jamadir/Komplexlabor/README.md

# Komplexlabor
Mechatronik Komplexlabor
Gemeinsamer Projektordner

Der Bericht: https://1drv.ms/w/s!AsvuwZcwYDiNgcJC_qBhzYxd2YB7aw?e=XfTh4c

Latex: https://www.overleaf.com/7794929636vkyntkxffhfc
