jamadir/Komplexlabor/Dokumentation/Präsentation Kugellabyrinth.pptx

## Kugellabyrinth

Wilhelmshaven, 20. Dezember 2022

- Komplexlabor Mechatronik
- Jannes Dirks, Jakob Kramer, Felix Merbt

## Inhalt

1. Analyse der Aufgabenstellung
2. Konzeptionierung
  1. Mechanische Teillösungen
  2. Auswahl des Antriebskonzepts
3. Konstruktionsphase
4. Fertigung
5. Programmierung
6. Inbetriebnahme / Testphase

Titel

## Analyse der Aufgabenstellung

- Kugellabyrinth-Spiel für Zwecke der Öffentlichkeitsarbeit
- Fernbedienung steuert Gerät mittels Lage- und Drehratensensor
- Betriebsspannung 12 V DC
- Material: Acrylglas-Laserzuschnitte
- Fertigung nur durch „Bordmittel“
- Baugröße: 200 x 200 x 100 mm
- Spielfläche des Labyrinths: 100 x 100 mm
- Abgabe: 20.12.2022

## Konzeptionierung

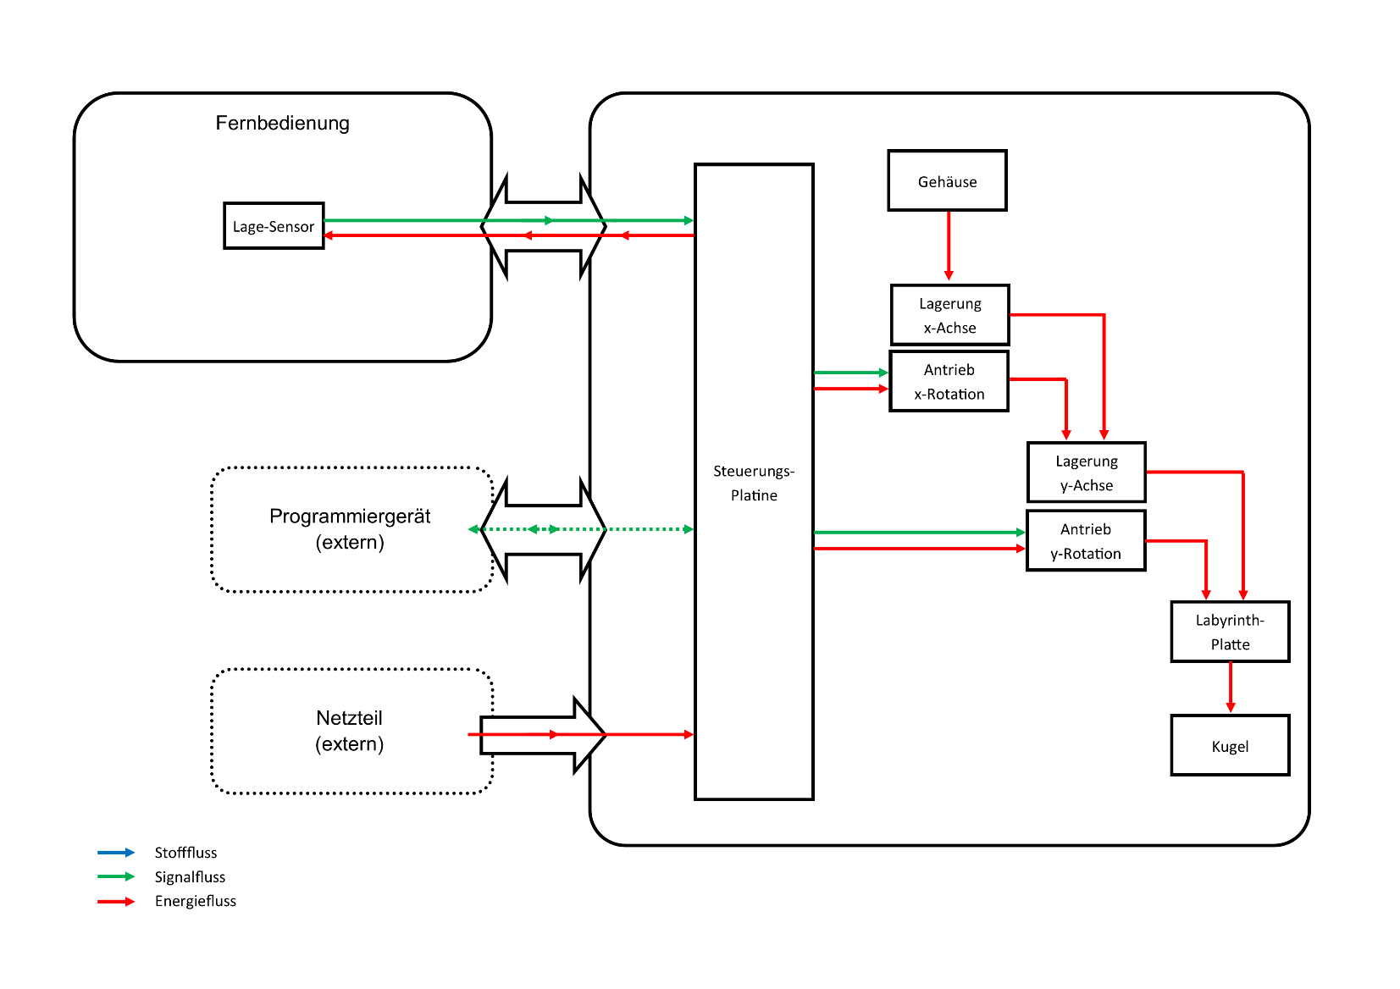
[picture p1: figure]

Bild 1

## Konzeptionierung

- Simples Design der Fernbedienung
- Servomotoren treiben Labyrinth direkt über Hebelarm an
- Steuerung mittels Arduino nano
- Achsen direkt in Material gelagert
- Verbindung zwischen Fernbedienung und Gerät mit USB-C

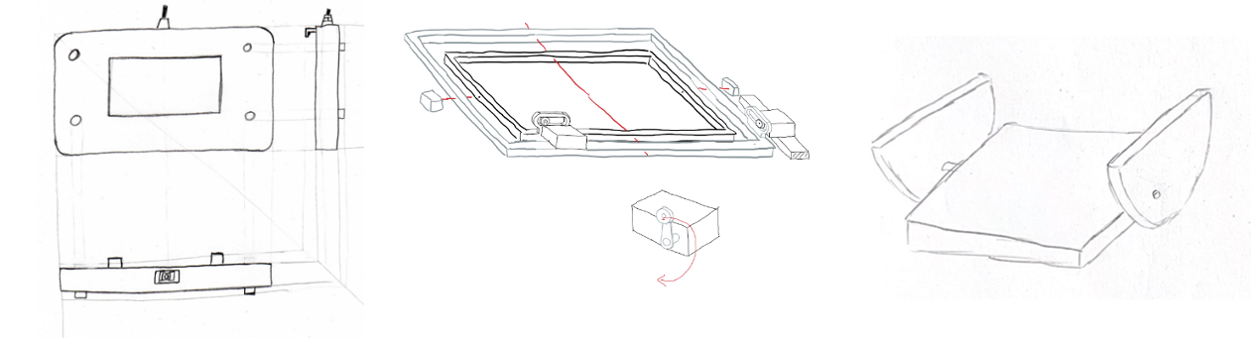
[picture p2: figure]

Bild 2

## Konstruktionsphase

- Festlegung auf die jeweiligen Teillösungen
- Ausarbeitung der Konzepte
- Grobes Skizzieren der Gesamtbaugruppe im Team
- Aufteilen der Baugruppen
- Konstruieren der Baugruppen
- Zusammenführen zur Gesamtbaugruppe
- Anpassen von Fehlkonstruktionen
- Verbesserung und Weiterentwicklung nach den Testaen

## Fertigung

- Fertigung Ausschließlich in der Hochschule
1. Raum H413b
2. Werkstatt ME 05
3. Lasercutter Me 09
- Besonderheit: Anpassung der Klemmung für die Baugruppe „Labyrinth“

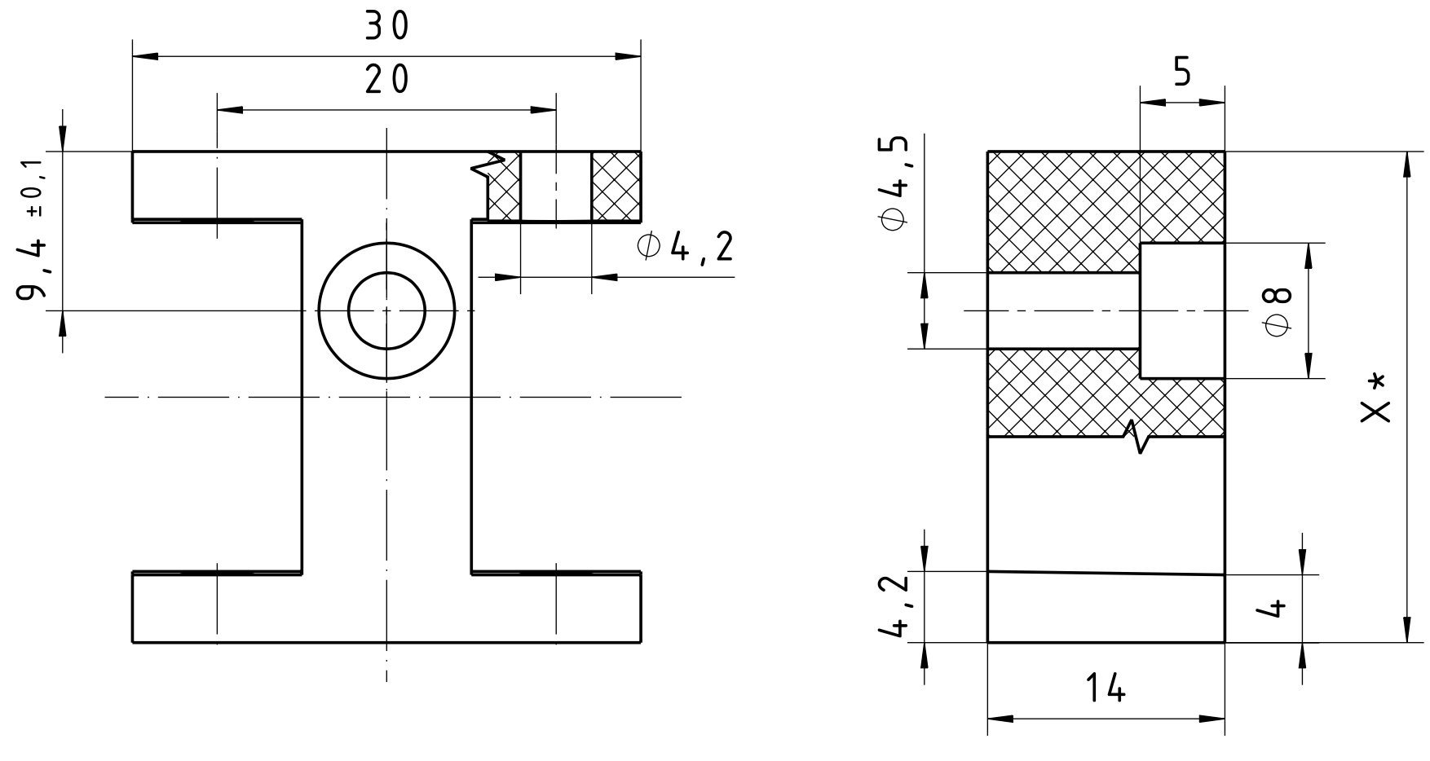
[picture p3: figure]

Bild 3

## Programmierung und Hardware

- Versuchsaufbau mit dem Motor HS-311 am Arduino Uno
- Versuchsaufbau mit dem Sensor MPU 6050 am Arduino Uno
- Erstes Verknüpfen von Motor und Sensor
- Weiterentwicklung des Programms
- Entwickeln und Verbessern der Hardware durch Arduino Nano

## Inbetriebnahme / Testphase

- Elektronikfehler, USB-C Codierung
- Elektronikfehler, EMV Probleme bei Versorgungsspannung > 5V
- Hebelarm kürzen, da nicht Plan
- Debugging im Programm
- Geräuschentwicklung in der Lagerung

## Erprobung des Anwendungsfalles

Testspiele von Probanden mit anschließender Kurzbewertung

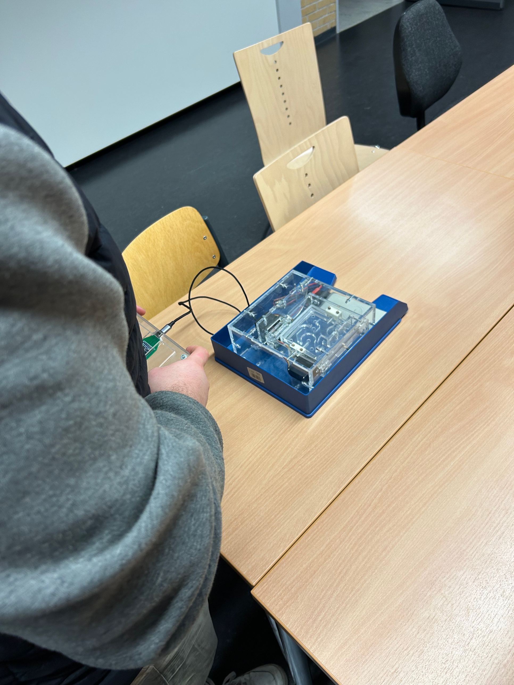
[picture p4: figure]
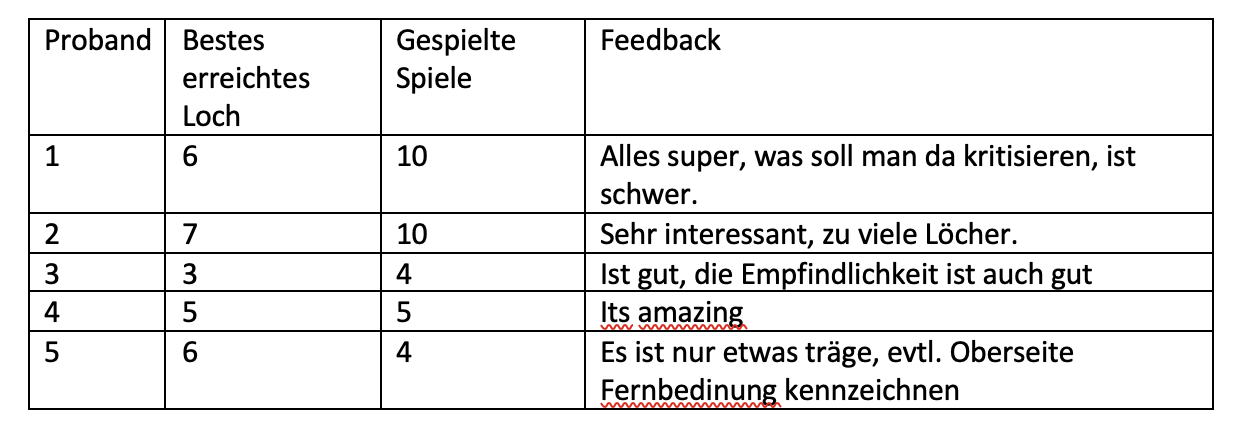
[picture p5: figure]

Tabelle 1

Bild 4

## Vielen Dank für Ihre Aufmerksamkeit
