jamadir/Komplexlabor/Dokumentation/Handskizzen/Aufhängung/Aufhängung.pdf

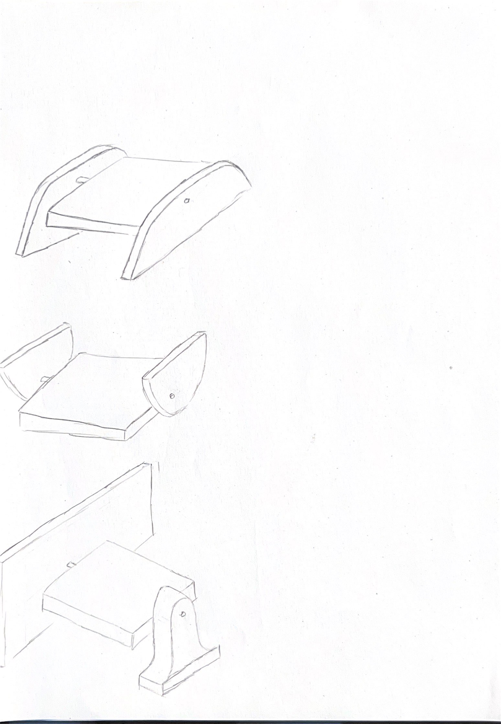
[picture p34: page 1]
