jamadir/Komplexlabor/Dokumentation/Handskizzen/Lagerung/Lagerung.pdf

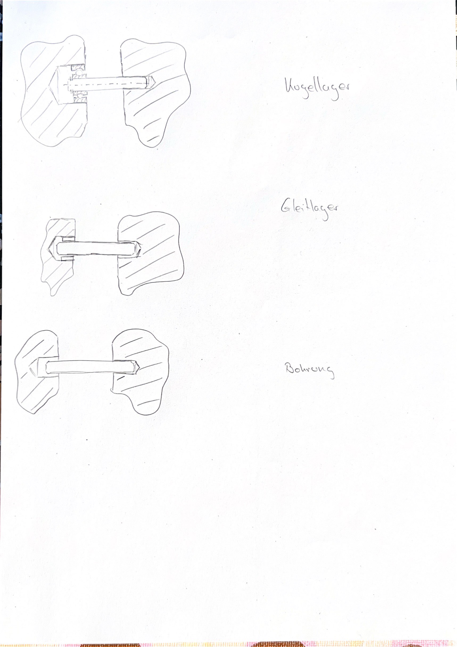
[picture p35: page 1]
