jamadir/Komplexlabor/Dokumentation/Handskizzen/Fernbedienung/Varianten Fernsteuerung Skizzen Schaltplan.pdf

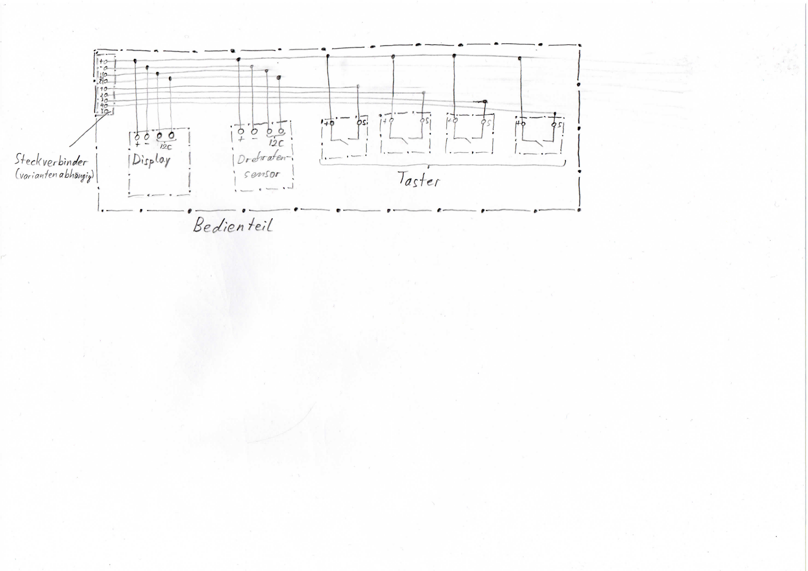
[picture p36: page 1]
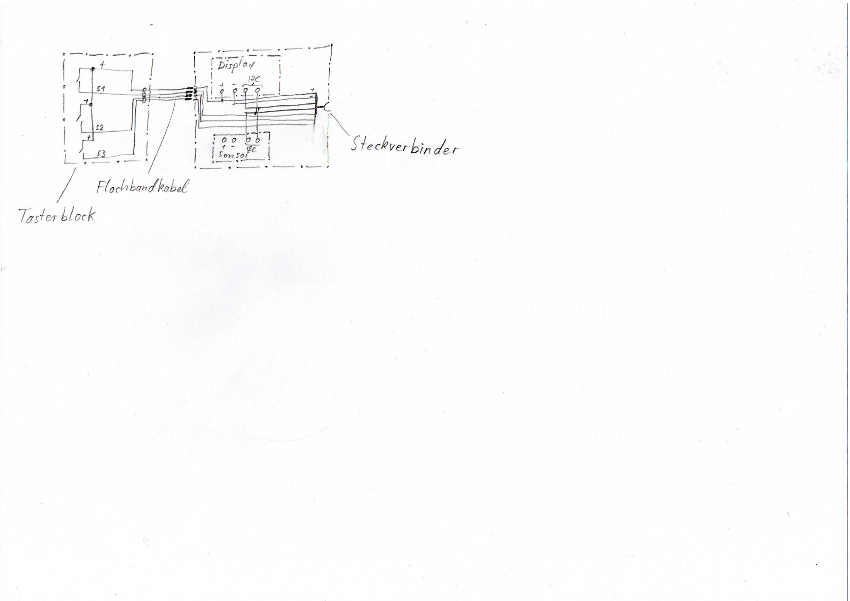
[picture p37: page 2]
