jamadir/Komplexlabor/Dokumentation/Handskizzen/Fernbedienung/Varianten Fernsteuerung.pdf

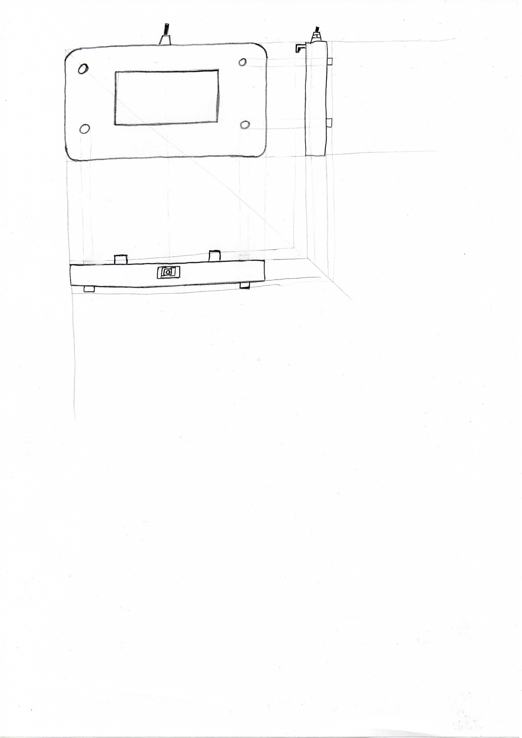
[picture p38: page 1]
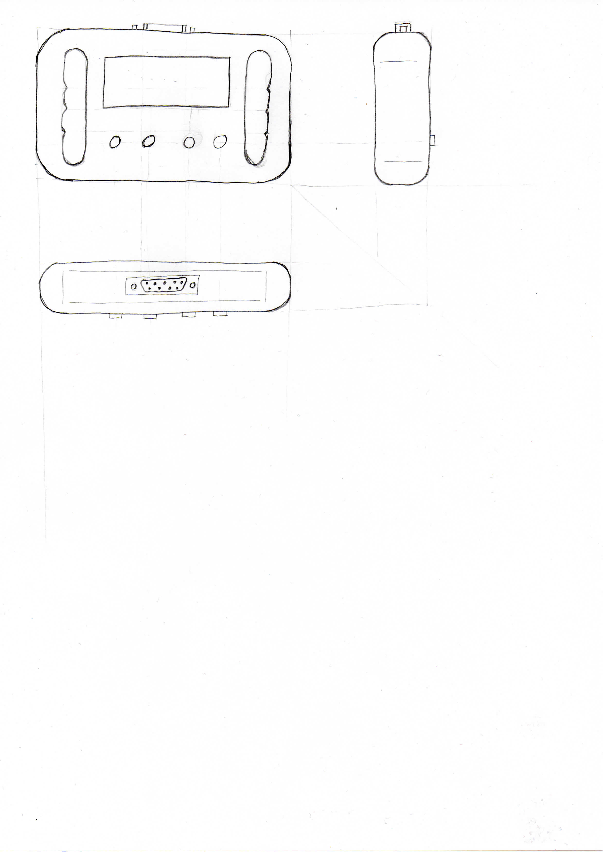
[picture p39: page 2]
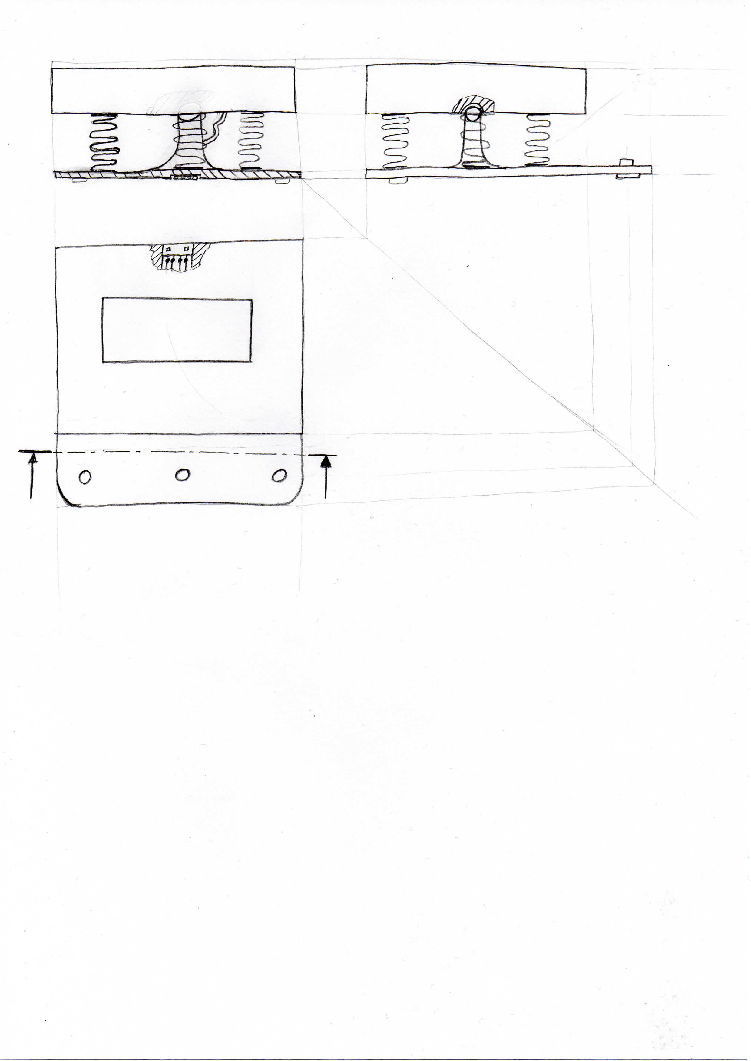
[picture p40: page 3]
