jamadir/Komplexlabor/Dokumentation/Funktionsstruktur/Funktionsstruktur V2.png

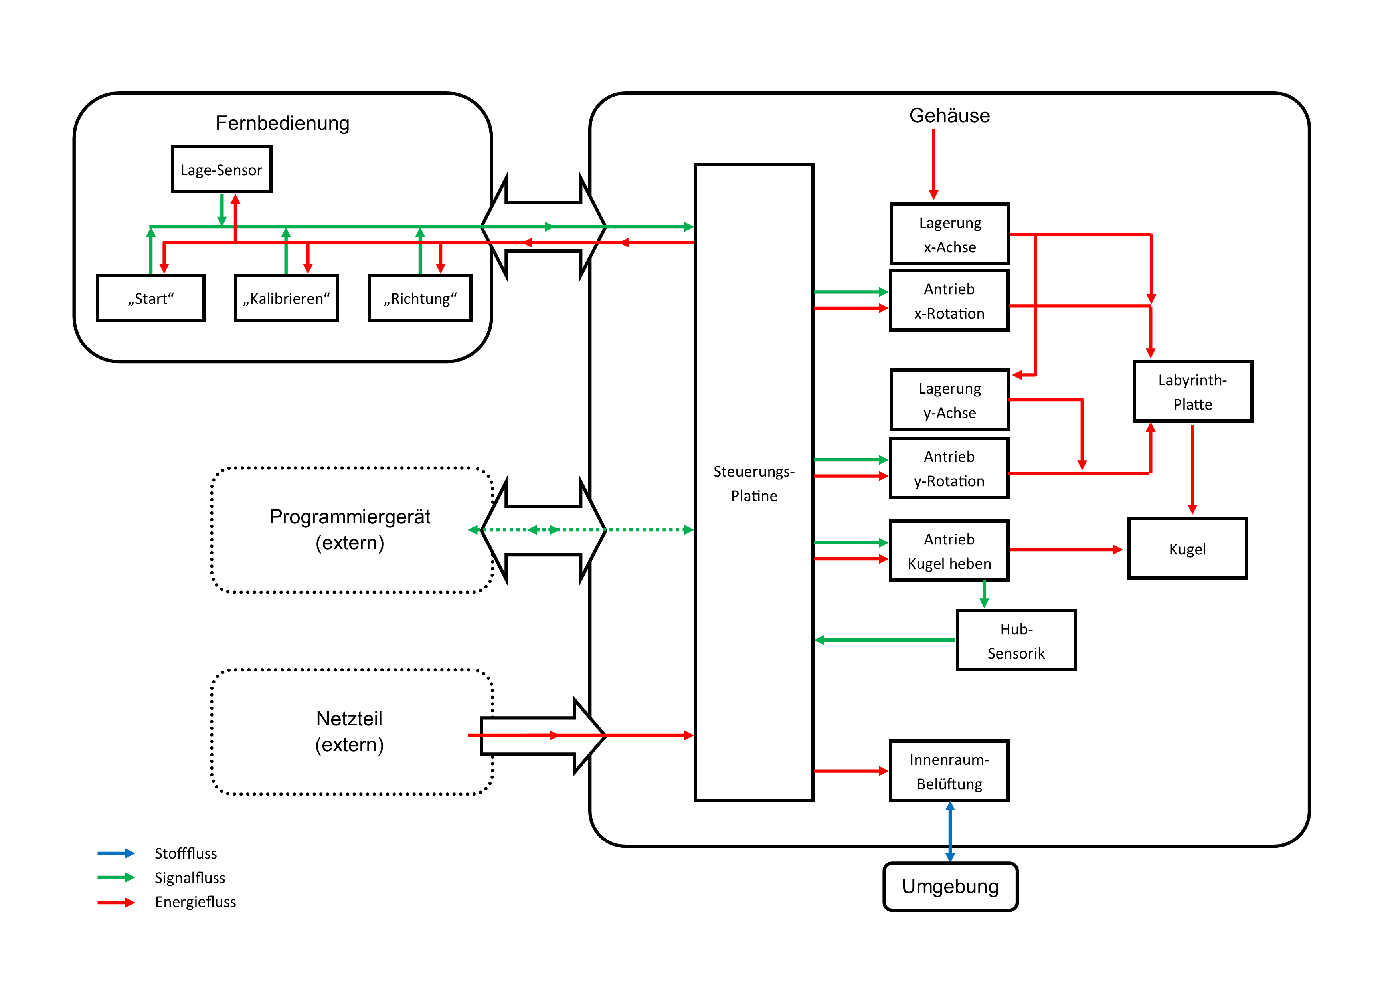
Dokumentation/Funktionsstruktur/Funktionsstruktur V2.png
