jamadir/Komplexlabor/CATIA/603.000.02.000_Aufhaengung/Stückliste Fernsteuerung.xls

1 |  | 2 | 3 | 4 |  |  |  |  | 5 |  | 6
Pos. |  | Menge | Einheit | Benennung |  |  |  |  | Sachnummer/Norm - Kurzbezeichnung |  | Bemerkung
1 |  | 1 | St. | Aufhängung 1 |  |  |  |  | 603.000.02.001
2 |  | 1 | St. | Aufhängung 2 |  |  |  |  | 603.000.02.002
3 |  | 1 | St. | Rahmen 1 |  |  |  |  | 603.000.02.003
4 |  | 1 | St. | Rahmen 1_2 |  |  |  |  | 603.000.02.004
5 |  | 1 | St. | Rahmen 2_1 |  |  |  |  | 603.000.02.005
6 |  | 1 | St. | Rahmen 2_2 |  |  |  |  | 603.000.02.006
7 |  | 2 | St. | Laufschiene |  |  |  |  | 603.000.02.007
8 |  | 1 | St. | Distanzstück |  |  |  |  | 603.000.02.008
9 |  | 1 | St. | Distanzstück L |  |  |  |  | 603.000.02.009
10 |  | 8 | St. | Sicherungsring |  |  |  |  | ANSI_B27_7M_3CM1_4
11 |  | 1 | St. | Servo Horn |  |  |  |  | Alu Servohorn 25T
12 |  | 1 | St. | Stift 15,8
13 |  | 1 | St. | Stift 19
14 |  | 2 | St. | Stift 30
15 |  | 5 | St. | Unterlegscheibe4 |  |  |  |  | ISO 7089 WASHER 4x9
16 |  | 1 | St. | Schraube 8mm |  |  |  |  | ISO_7047_M2.5x8
17 |  | 1 | St. | Schraube 12mm |  |  |  |  | ISO_4762_M2.5x12
18 |  | 2 | St. | Servo Motor |  |  |  |  | Hitec HS-311
19 |  | 2 | St. | Kugellager |  |  |  |  | Bearing w 6 x m2,5
20 |  | 4 | St. | Schraube 20mm |  |  |  |  | ISO 4762 M3x20
21 |  | 4 | St. | Vierkantmutter |  |  |  |  | din 562 m3 04
22 |  | 8 | St. | Senkkopfschraube |  |  |  |  | ISO 10642 M3x10
23 |  | 8 | St. | Mutter M3 |  |  |  |  | ISO 4032 M3
24 |  | 8 | St. | Unterlegscheibe3 |  |  |  |  | ISO 7089 WASHER 3x7
25 |  | 4 | St. | Schraube 16mm |  |  |  |  | ISO 10642 M3x16
26
27
 |  |  |  |  |  |  | Datum | Name |  | Aufhängung
 |  |  |  |  |  | Bearb. | 2022-11-08 | Dirks
 |  |  |  |  |  | Gepr.
 |  |  |  |  |  | Norm.
 |  |  |  |  |  |  |  |  |  |  |  | Blatt
 |  |  |  |  |  |  |  |  |  | 603.000.02.000 |  | 1
 |  |  |  |  |  |  |  |  |  |  |  | 1 Bl.
Zust. | Änderung |  |  | Datum | Name
