jamadir/Komplexlabor/Fertigung/603.000.05.000_Steuer-Platine/SMD BOM 603.000.05.000, 603.000.04.005.xlsx

No. | Quantity | Comment | Designator | Footprint | Value | Manufacturer Part | Manufacturer | Supplier Part | Supplier
1 | 1 | Power connector | CN1 | CONN-TH_2P-P5.08_DB2EV-5.08-2P |  | DB2EV-5.08-2P-GN | DIBO(地博电气) | C395733 | LCSC
2 | 1 | Servo connector | H1 | HDR-TH_6P-P2.54-V-M-1
3 | 1 | ARDUINO_NANO | U1 | COMM-TH_ARDUINO_NANO |  | ARDUINO_NANO |  | C9900017879 | LCSC
4 | 1 | GY521 MODULE | U2 | MPU6050 GY521 TRINITY
5 | 1 | DC-DC step down converter | U3 | DC-DC step down converter
6 | 2 | TYPE-C-31-M-12 | USBC1,USBC2 | USB-C_SMD-TYPE-C-31-M-12 |  | TYPE-C-31-M-12 | 韩国韩荣 | C165948 | LCSC
