jamadir/Komplexlabor/CATIA/Stückliste Kugellabyrinth.xls

1 |  | 2 | 3 | 4 |  |  |  |  | 5 |  | 6
Pos. |  | Menge | Einheit | Benennung |  |  |  |  | Sachnummer/Norm - Kurzbezeichnung |  | Bemerkung
1 |  | 1 | St. | Gehäuse |  |  |  |  | 603.000.01.000
2 |  | 1 | St. | Aufhängung |  |  |  |  | 603.000.02.000
3 |  | 1 | St. | Labyrinth |  |  |  |  | 603.000.03.000
4 |  | 1 | St. | Fernbedienung |  |  |  |  | 603.000.04.000
5 |  | 1 | St. | Steuer-Platine |  |  |  |  | 603.000.05.000
6 |  | 4 | St. | Schraube M3x16 |  |  |  |  | ISO 4762 M3x16
7 |  | 8 | St. | Unterlegscheibe D3,5 |  |  |  |  | ISO 7089
8 |  | 4 | St. | Mutter M3 |  |  |  |  | ISO 4032
9 |  | 1 | St. | Verbindungskabel |  |  |  |  | USB-C
10
11
12
13
14
15
16
17
18
19
20
21
22
23
24
25
26
27
 |  |  |  |  |  |  | Datum | Name |  | Kugellabyrinth
 |  |  |  |  |  | Bearb. | 2022-12-20 | Kramer
 |  |  |  |  |  | Gepr.
 |  |  |  |  |  | Norm.
 |  |  |  |  |  |  |  |  |  |  |  | Blatt
 |  |  |  |  |  |  |  |  |  | 603.000.00.000 |  | 1
 |  |  |  |  |  |  |  |  |  |  |  | 1 Bl.
Zust. | Änderung |  |  | Datum | Name
