jamadir/Komplexlabor/CATIA/603.000.03.000_Labyrinth/Stückliste Labyrinth.xls

1 |  | 2 | 3 | 4 |  |  |  |  | 5 |  | 6
Pos. |  | Menge | Einheit | Benennung |  |  |  |  | Sachnummer/Norm - Kurzbezeichnung |  | Bemerkung
1 |  | 1 | St. | Auffangplatte |  |  |  |  | 603.000.03.001
2 |  | 1 | St. | Zwischenplatte |  |  |  |  | 603.000.03.002
3 |  | 1 | St. | Lauffläche |  |  |  |  | 603.000.03.003
4 |  | 1 | St. | Labyrinthplatte |  |  |  |  | 603.000.03.004
5 |  | 1 | St. | Abdeckplatte |  |  |  |  | 603.000.03.005
6 |  | 1 | St. | Rampe 1 |  |  |  |  | 603.000.03.006
7 |  | 1 | St. | Rampe 2 |  |  |  |  | 603.000.03.007
8 |  | 2 | St. | Lagerblock |  |  |  |  | 603.000.03.008
9 |  | 4 | St. | Sicherungsstift |  |  |  |  | 603.000.03.009
10 |  | 8 | St. | Sicherungsring |  |  |  |  | ANSI_B27_7M_3CM1_4
11 |  | 1 | St. | Kugel 6mm |  |  |  |  | DIN 5401
12
13
14
15
16
17
18
19
20
21
22
23
24
25
26
27
 |  |  |  |  |  |  | Datum | Name |  | Kugellabyrinth
 |  |  |  |  |  | Bearb. | 2022-12-20
 |  |  |  |  |  | Gepr.
 |  |  |  |  |  | Norm.
 |  |  |  |  |  |  |  |  |  |  |  | Blatt
 |  |  |  |  |  |  |  |  |  | 603.000.00.000 |  | 1
 |  |  |  |  |  |  |  |  |  |  |  | 1 Bl.
Zust. | Änderung |  |  | Datum | Name
