jamadir/Komplexlabor/CATIA/603.000.01.000_Gehaeuse/Stückliste Gehäuse.xls

1 |  | 2 | 3 | 4 |  |  |  |  | 5 |  | 6
Pos. |  | Menge | Einheit | Benennung |  |  |  |  | Sachnummer/Norm - Kurzbezeichnung |  | Bemerkung
1 |  | 1 | St. | Boden |  |  |  |  | 603.000.01.001
2 |  | 1 | St. | Seitenwand vorne |  |  |  |  | 603.000.01.002
3 |  | 1 | St. | Seitenwand links |  |  |  |  | 603.000.01.003
4 |  | 1 | St. | Seitenwand hinten |  |  |  |  | 603.000.01.004
5 |  | 1 | St. | Seitenwand rechts |  |  |  |  | 603.000.01.005
6 |  | 1 | St. | Deckel |  |  |  |  | 603.000.01.006
7 |  | 20 | St. | Schraube |  |  |  |  | ISO 4762 - M3x20 - 8.8
8 |  | 20 | St. | Scheibe |  |  |  |  | ISO 7092-3-200 HV
9 |  | 20 | St. | Vierkantmutter |  |  |  |  | DIN 562 - M3 - 04
10
11
12
13
14
15
16
17
18
19
20
21
22
23
24
25
26
27
 |  |  |  |  |  |  | Datum | Name |  | Gehäuse
 |  |  |  |  |  | Bearb. | 2022-12-20 | Kramer
 |  |  |  |  |  | Gepr.
 |  |  |  |  |  | Norm.
 |  |  |  |  |  |  |  |  |  |  |  | Blatt
 |  |  |  |  |  |  |  |  |  | 603.000.01.000 |  | 1
 |  |  |  |  |  |  |  |  |  |  |  | 1 Bl.
Zust. | Änderung |  |  | Datum | Name
