jamadir/Komplexlabor/CATIA/603.000.04.000_Fernsteuerung/Stückliste Fernsteuerung.xls

1 |  | 2 | 3 | 4 |  |  |  |  | 5 |  | 6
Pos. |  | Menge | Einheit | Benennung |  |  |  |  | Sachnummer/Norm - Kurzbezeichnung |  | Bemerkung
1 |  | 1 | St. | Grundplatte |  |  |  |  | 603.000.04.001
2 |  | 2 | St. | Befestigungsplatte |  |  |  |  | 603.000.04.002
3 |  | 1 | St. | Distanzplatte |  |  |  |  | 603.000.04.003
4 |  | 1 | St. | Abdeckplatte |  |  |  |  | 603.000.04.004
5 |  | 1 | St. | Sensorplatine |  |  |  |  | 603.000.04.005
6 |  | 2 | St. | Zylinderstift |  |  |  |  | ISO 2338 - 3 h8 x 12
7 |  | 4 | St. | Schraube |  |  |  |  | ISO 4762 - M3x25 - 8.8
8 |  | 8 | St. | Scheibe |  |  |  |  | ISO 7092-3-200 HV
9 |  | 4 | St. | Sechskantmutter |  |  |  |  | ISO 4032 - M3 - 8
10
11
12
13
14
15
16
17
18
19
20
21
22
23
24
25
26
27
 |  |  |  |  |  |  | Datum | Name |  | Fernsteuerung
 |  |  |  |  |  | Bearb. | 2022-10-31 | Merbt
 |  |  |  |  |  | Gepr.
 |  |  |  |  |  | Norm.
 |  |  |  |  |  |  |  |  |  |  |  | Blatt
 |  |  |  |  |  |  |  |  |  | 603.000.04.000 |  | 1
 |  |  |  |  |  |  |  |  |  |  |  | 1 Bl.
Zust. | Änderung |  |  | Datum | Name
