jamadir/Komplexlabor/CATIA/603.000.04.000_Fernsteuerung/USB-C Breakout Board.stl

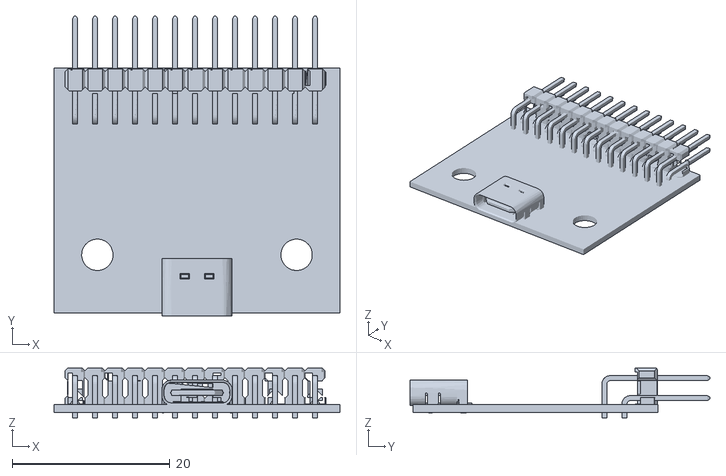
[picture p42: CAD file, 2022-10-18]
CATIA/603.000.04.000_Fernsteuerung/USB-C Breakout Board.stl
36.3 x 38.1 x 6.33
