jamadir/Komplexlabor/Fertigung/603.000.02.000_Aufhaengung/Distanzstueck_Lagerung.stl

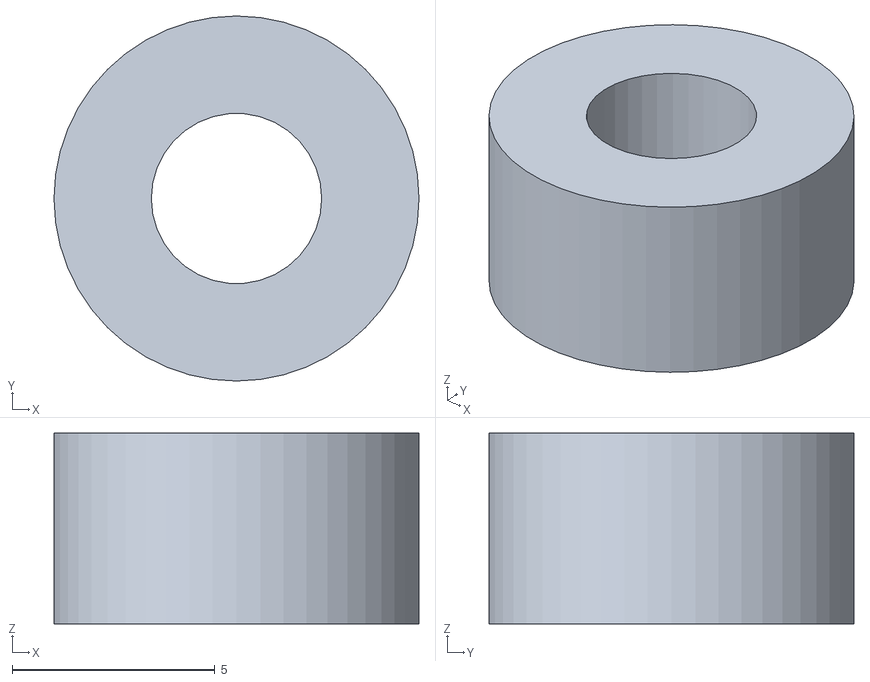
[picture p43: CAD file, 2022-11-28]
Fertigung/603.000.02.000_Aufhaengung/Distanzstueck_Lagerung.stl
9.00 x 9.00 x 4.70
