jamadir/Komplexlabor/Fertigung/603.000.03.000_Labyrinth/Lagereinsatz.stl

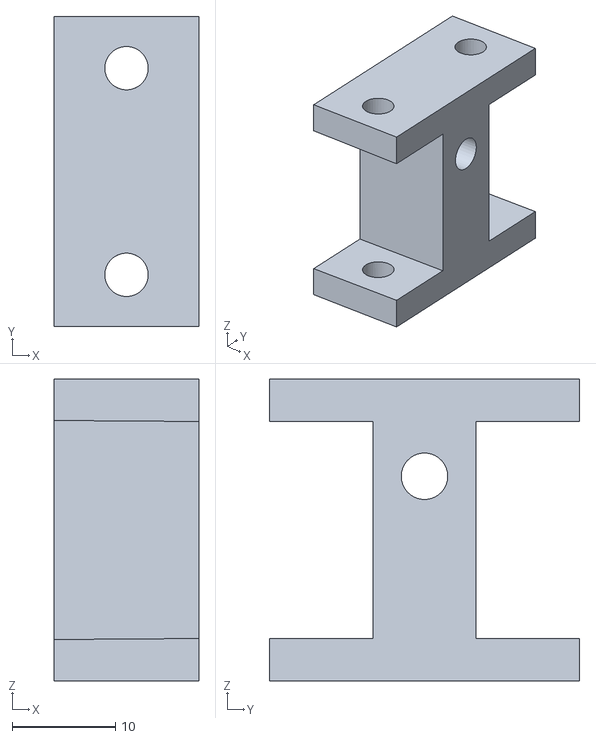
[picture p44: CAD file, 2022-11-28]
Fertigung/603.000.03.000_Labyrinth/Lagereinsatz.stl
14.0 x 30.0 x 29.2
