jamadir/Komplexlabor/Modell prototyp/rahmen aussen innen.stl

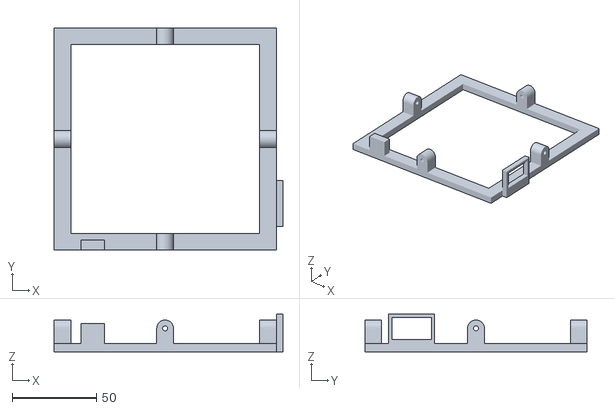
[picture p45: CAD file, 2022-10-09]
Modell prototyp/rahmen aussen innen.stl
136.0 x 132.0 x 22.5
