jamadir/Komplexlabor/Modell prototyp/rahmen aussen ausseb.stl

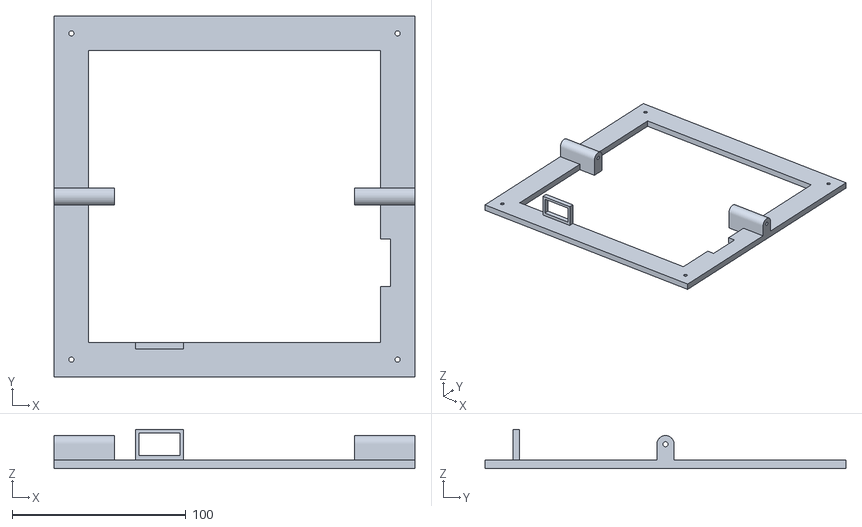
[picture p46: CAD file, 2022-10-09]
Modell prototyp/rahmen aussen ausseb.stl
208.0 x 208.0 x 22.5
