jamadir/Komplexlabor/Modell prototyp/gestell.stl

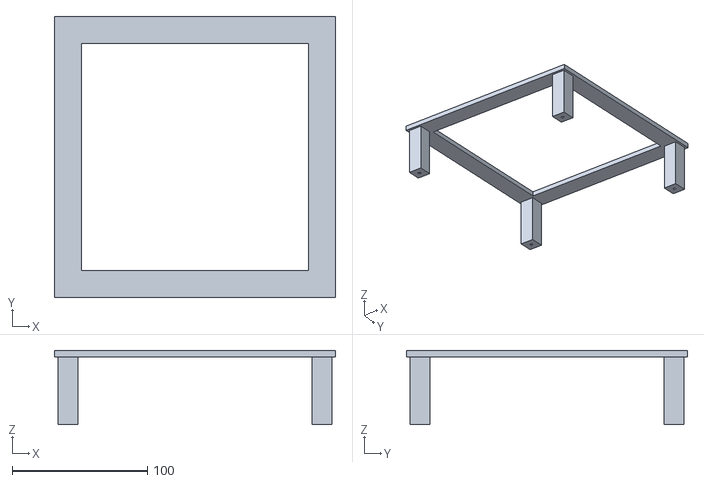
[picture p47: CAD file, 2022-10-09]
Modell prototyp/gestell.stl
208.0 x 208.0 x 55.0
