jamadir/Komplexlabor/Modell prototyp/labyrinth.stl

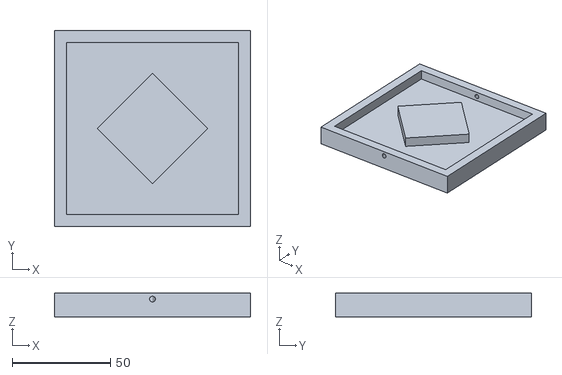
[picture p48: CAD file, 2022-10-08]
Modell prototyp/labyrinth.stl
100.0 x 100.0 x 12.0
