jamadir/Komplexlabor/Modell prototyp/laufschiene.stl

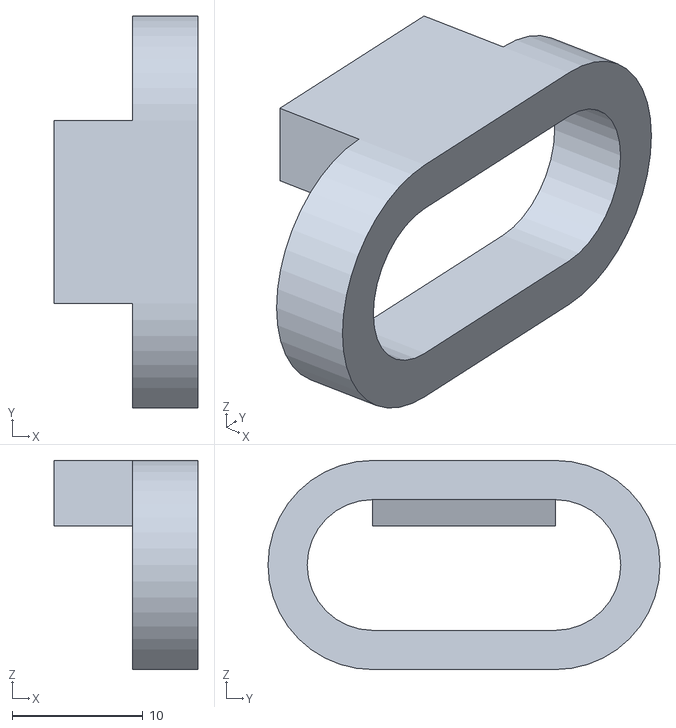
[picture p49: CAD file, 2022-10-08]
Modell prototyp/laufschiene.stl
11.0 x 30.0 x 16.0
