jamadir/Komplexlabor/(list of files, cad)

Other CAD files:
Baugruppe Aufhängung/Armkonstruktion.CATProduct
Baugruppe Aufhängung/Aufhaengung aussen.CATPart
Baugruppe Aufhängung/Aufhaengung und Servos.CATProduct
Baugruppe Aufhängung/Fuehrung.2.CATPart
Baugruppe Aufhängung/Hebelarm.CATPart
Baugruppe Aufhängung/Kugellager.CATPart
Baugruppe Aufhängung/M2.5 Schraube.CATPart
Baugruppe Aufhängung/Rahmen innen.CATPart
Baugruppe Aufhängung/Servo.CATPart
Baugruppe Aufhängung/Servo2.CATPart
Baugruppe Aufhängung/Unterlegscheibe.CATPart
Baugruppe Gehäuse/Deckel.1.CATPart
Baugruppe Gehäuse/Gehause.CATProduct
CATIA/603.000.00.000_Kugellabyrinth.CATProduct
CATIA/603.000.01.000_Gehaeuse/Gehaeuse.CATProduct
CATIA/603.000.01.000_Gehaeuse/Product1.CATProduct
CATIA/603.000.02.000_Aufhaengung/Laufschiene_Lager.CATPart
CATIA/603.000.02.000_Aufhaengung/Rahmen.CATProduct
CATIA/603.000.03.000_Labyrinth/Auffangplatte.CATPart
CATIA/603.000.03.000_Labyrinth/Labyrinth.CATProduct
CATIA/603.000.03.000_Labyrinth/Lagereinsatz.CATPart
CATIA/603.000.03.000_Labyrinth/Rampe 0-6.CATPart
CATIA/603.000.03.000_Labyrinth/Rampe 6-9.CATPart
CATIA/603.000.05.000_Steuer-Platine/Platine/Platine/Platine.CATProduct
Fertigung/603.000.01.000_Gehaeuse/Gehaeuse_Bodenplatte.CATPart
Fertigung/603.000.01.000_Gehaeuse/Gehaeuse_Deckel.CATPart
Fertigung/603.000.01.000_Gehaeuse/Gehaeuse_Seitenplatte_1.CATPart
Fertigung/603.000.01.000_Gehaeuse/Gehaeuse_Seitenplatte_2.CATPart
Fertigung/603.000.01.000_Gehaeuse/Gehaeuse_Seitenplatte_3.CATPart
Fertigung/603.000.01.000_Gehaeuse/Gehaeuse_Seitenplatte_4.CATPart
Fertigung/603.000.02.000_Aufhaengung/Aufhaengung_1.CATPart
Fertigung/603.000.02.000_Aufhaengung/Aufhaengung_2.CATPart
Fertigung/603.000.02.000_Aufhaengung/Distanzstueck.CATPart
Fertigung/603.000.02.000_Aufhaengung/Distanzstueck_Lagerung.CATPart
Fertigung/603.000.02.000_Aufhaengung/Laufschiene_Lager.CATPart
Fertigung/603.000.02.000_Aufhaengung/Rahmen_Stange_1.CATPart
Fertigung/603.000.02.000_Aufhaengung/Rahmen_Stange_1_1.CATPart
Fertigung/603.000.02.000_Aufhaengung/Rahmen_Stange_2.CATPart
Fertigung/603.000.02.000_Aufhaengung/Rahmen_Stange_2_1.CATPart
Fertigung/603.000.03.000_Labyrinth/Abdeckplatte.CATPart
Fertigung/603.000.03.000_Labyrinth/Auffangplatte.CATPart
Fertigung/603.000.03.000_Labyrinth/Labyrinthplatte.CATPart
Fertigung/603.000.03.000_Labyrinth/Lagereinsatz.CATPart
Fertigung/603.000.03.000_Labyrinth/Laufflaeche.CATPart
Fertigung/603.000.03.000_Labyrinth/Rampe 0-6.CATPart
Fertigung/603.000.03.000_Labyrinth/Rampe 6-9.CATPart
Fertigung/603.000.03.000_Labyrinth/Zwischenplatte.CATPart
Fertigung/603.000.04.000_Fernsteuerung/Abdeckplatte.CATPart
Fertigung/603.000.04.000_Fernsteuerung/Distanzlage_6mm.CATPart
Fertigung/603.000.04.000_Fernsteuerung/Grundplatte.CATPart
Fertigung/603.000.04.000_Fernsteuerung/Verstiftung.CATPart
Fertigung/603.000.05.000_Steuer-Platine/Platine/Platine/COMPOUND.CATPart
Fertigung/603.000.05.000_Steuer-Platine/Platine/Platine/COMPOUND_Duplicate_1.CATPart
Fertigung/603.000.05.000_Steuer-Platine/Platine/Platine/COMPOUND_Duplicate_11.CATPart
Fertigung/603.000.05.000_Steuer-Platine/Platine/Platine/COMPOUND_Duplicate_12.CATPart
Fertigung/603.000.05.000_Steuer-Platine/Platine/Platine/COMPOUND_Duplicate_13.CATPart
Fertigung/603.000.05.000_Steuer-Platine/Platine/Platine/COMPOUND_Duplicate_2.CATPart
Fertigung/603.000.05.000_Steuer-Platine/Platine/Platine/COMPOUND_Duplicate_3.CATPart
Fertigung/603.000.05.000_Steuer-Platine/Platine/Platine/COMPOUND_Duplicate_4.CATPart
Fertigung/603.000.05.000_Steuer-Platine/Platine/Platine/COMPOUND_Duplicate_5.CATPart
Fertigung/603.000.05.000_Steuer-Platine/Platine/Platine/COMPOUND_Duplicate_6.CATPart
Fertigung/603.000.05.000_Steuer-Platine/Platine/Platine/COMPOUND_Duplicate_7.CATPart
Fertigung/603.000.05.000_Steuer-Platine/Platine/Platine/COMPOUND_Duplicate_8.CATPart
Fertigung/603.000.05.000_Steuer-Platine/Platine/Platine/Platine.CATProduct
Fertigung/603.000.05.000_Steuer-Platine/Platine/Platine/Puffer_Platine.CATPart
Fertigung/603.000.05.000_Steuer-Platine/Platine/Platine/SOLID.CATPart
Fertigung/603.000.05.000_Steuer-Platine/Platine/Platine/SOLID_Duplicate_10.CATPart
Fertigung/603.000.05.000_Steuer-Platine/Platine/Platine/SOLID_Duplicate_9.CATPart
Modell prototyp/Labyrinth.CATPart
Modell prototyp/Labyrinthspiel.CATProduct
Modell prototyp/Part4.CATPart
Modell prototyp/Rahmen aussen aussen.CATPart
Modell prototyp/Rahmen aussen.CATPart
Modell prototyp/bodengestell.CATPart
