jamadir/Komplexlabor/Dokumentation/Testlauf/Testlauf_mit_Probanden.docx

Proband | Bestes erreichtes Loch | Gespielte Spiele | Feedback
1 | 6 | 10 | Alles super, was soll man da kritisieren, ist schwer.
2 | 7 | 10 | Sehr interessant, zu viele Löcher.
3 | 3 | 4 | Ist gut, die Empfindlichkeit ist auch gut
4 | 5 | 5 | Its amazing
5 | 6 | 4 | Es ist nur etwas träge, evtl. Oberseite Fernbedinung kennzeichnen
