jamadir/Komplexlabor/(threads)

Thread 2 (2022-09-21):

Drei Varianten Fernbedienung Aufhängung Motoren erstellen

jamadir, 2022-09-21:

Closed 2022-10-03.

Thread 14 (2022-09-22):

Gesamtzeichnung Komplettsystem

jamadir, 2022-09-22:
Antrieb, Sensorik, Kabelfernsteuerung und Ansteuerelektronik
incl. Stückliste, Baugruppenzeichnung

Closed 2023-01-30.

Thread 8 (2022-09-22):

Gesamtkonzept erstellen

jamadir, 2022-09-22:
Funktionsstruktur

wangerfel, 2022-09-23:
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

jamadir, 2022-09-24:
Mit Github desktop kannst du einen Ordner erstellen der per commit (mit kommentar) und push ins repository geladen wird
https://desktop.github.com

Repository aus dem internet in den Ordner klonen
Danach Änderungen in dem Ordner durchführen
Github desktop öffnen:
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
Dann Push origin:
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

Wenn der Arbeitspunkt abgeschlossen ist kann das Issue geschlossen werden:
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

jamadir, 2022-09-24:
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

Jetzt sieht man unter "Milestones" den projektfortschritt

Closed 2022-09-24.
