jamadir/Komplexlabor/Entwicklung/Varianten Motor.pdf

# varianten Motor

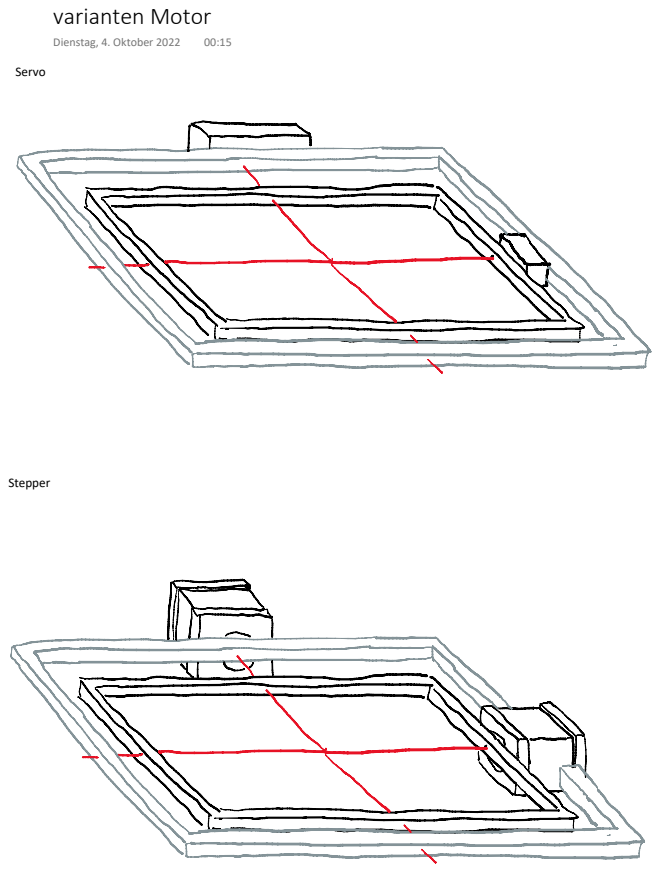
[picture p50: page 1]
Servo; Stepper; Dienstag, 4. Oktober 2022

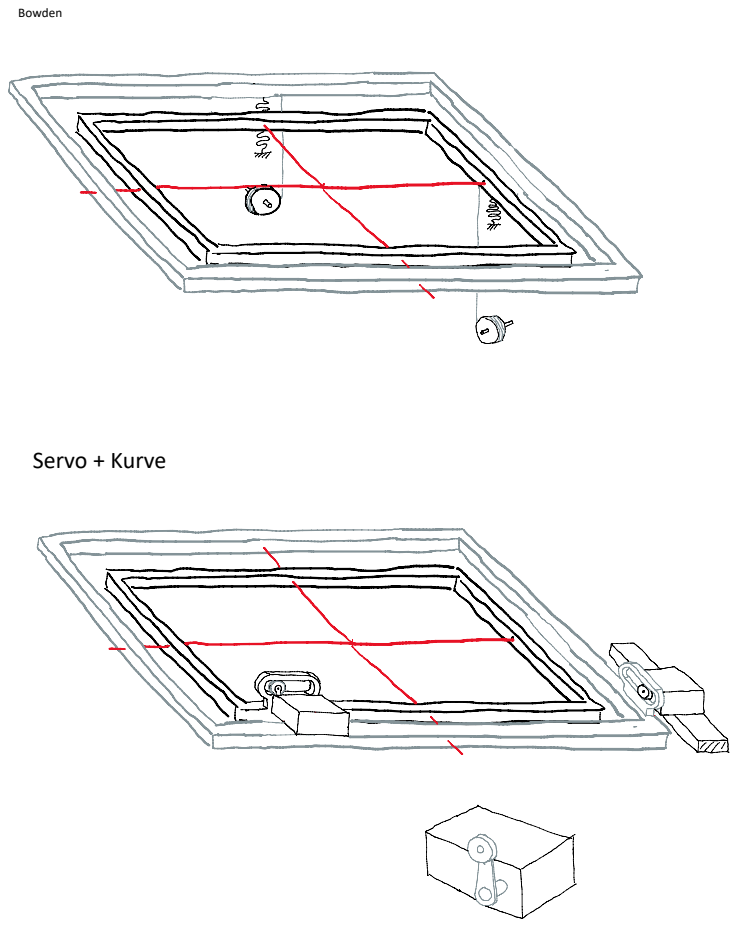
[picture p51: page 2]
Bowden; Servo + Kurve
