jamadir/Komplexlabor/Fertigung/603.000.05.000_Steuer-Platine/Schematic 603.000.05.000, 603.000.04.005.pdf

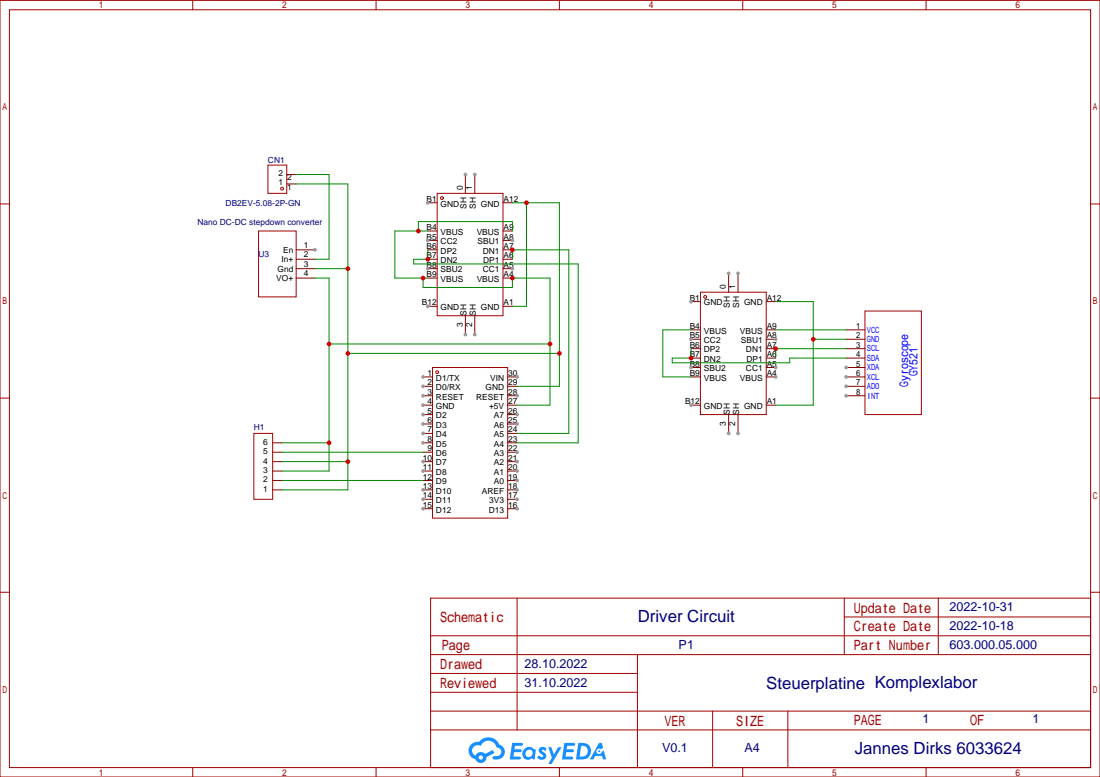
[picture p52: page 1]

Nano DC-DC stepdown converter
