jamadir/Komplexlabor/Fertigung/603.000.05.000_Steuer-Platine/Platinenlayout 603.000.05.000, 603.000.04.005.pdf

# H1USBC2

U2

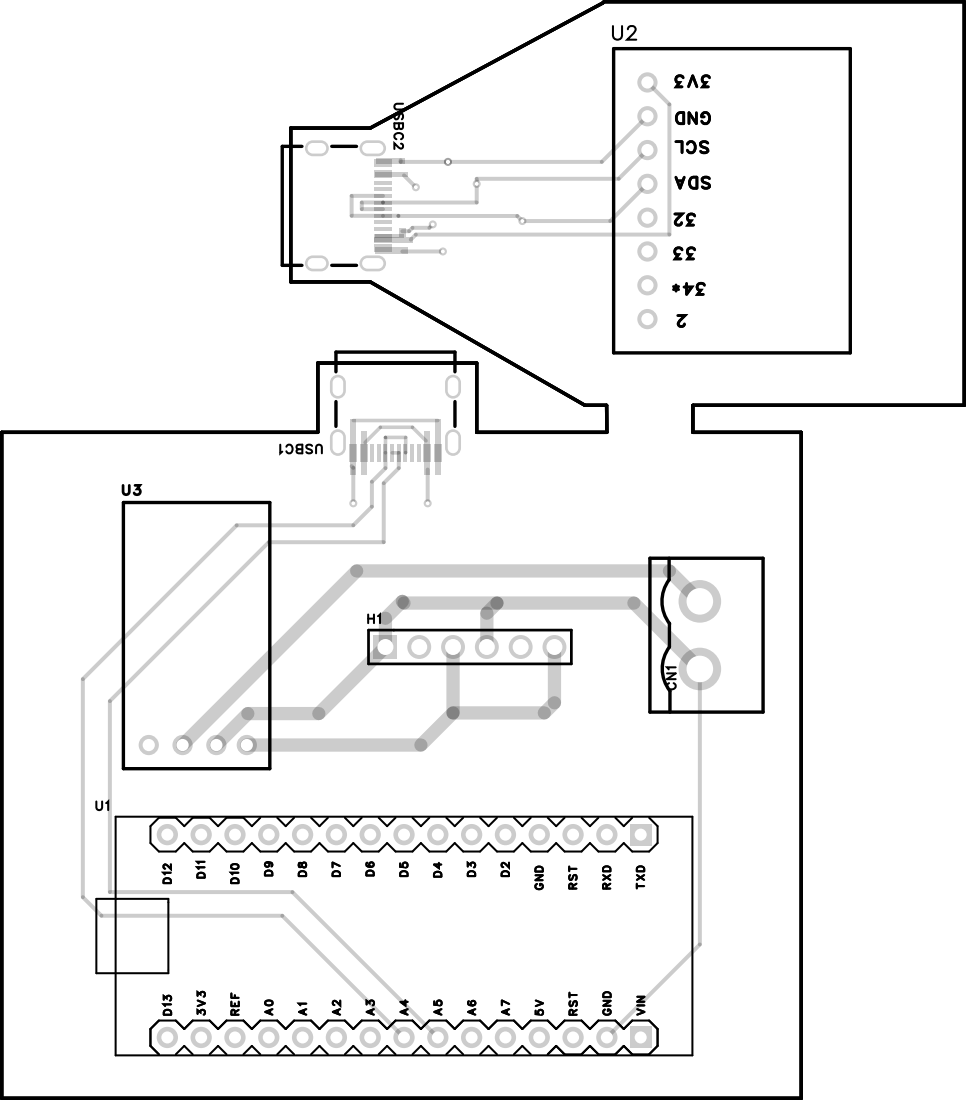
[picture p53: page 1]

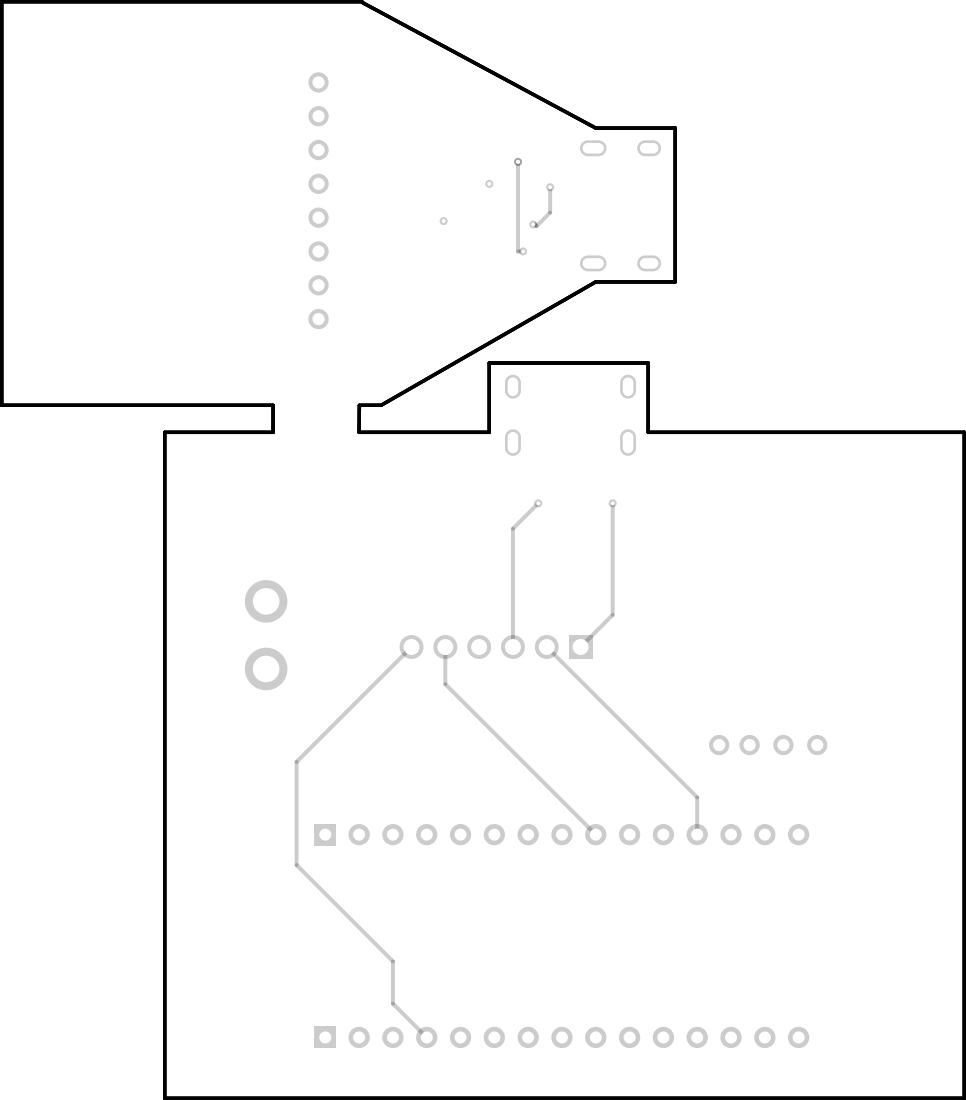
[picture p54: page 2]

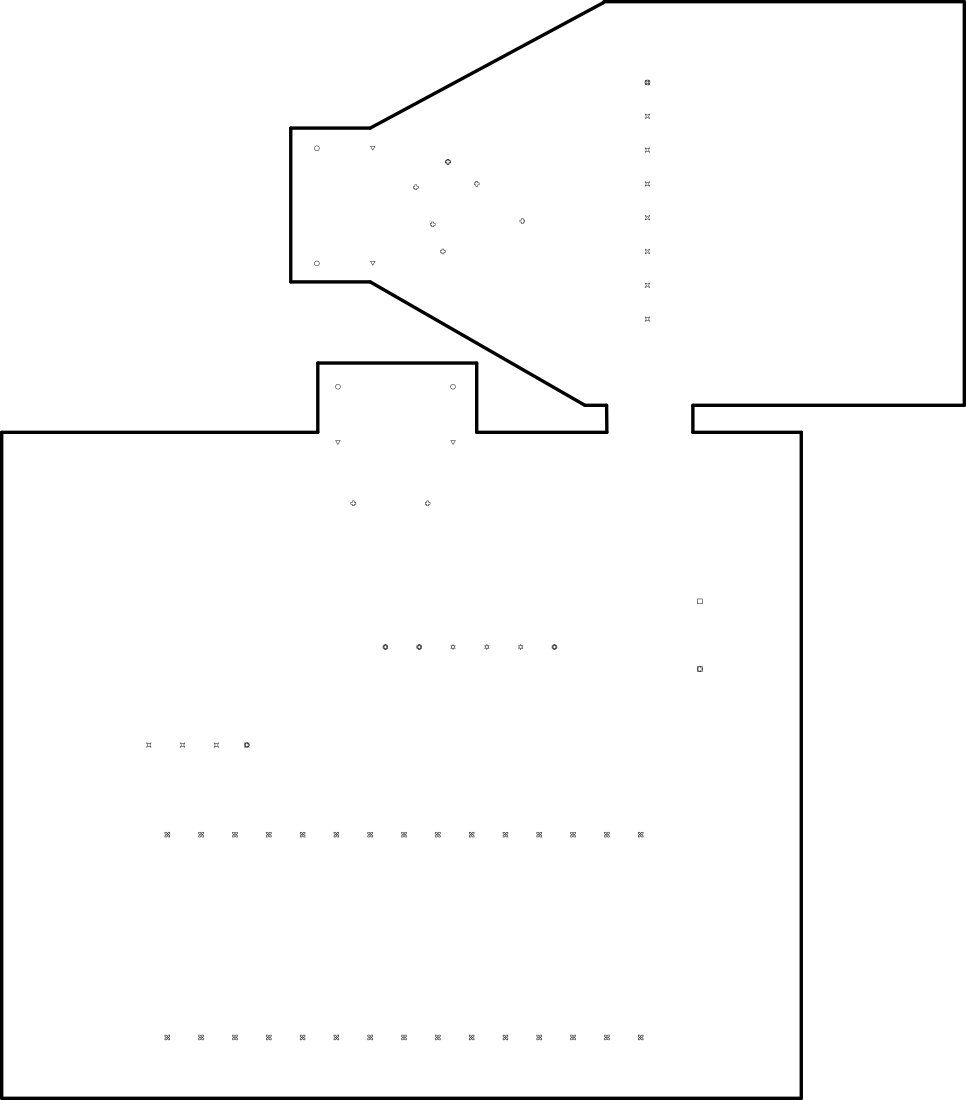
[picture p55: page 3]
