jamadir/Komplexlabor/CATIA/603.000.02.000_Aufhaengung/PDF-Zeichnungen/603.000.02.007_Laufschiene_V2.pdf

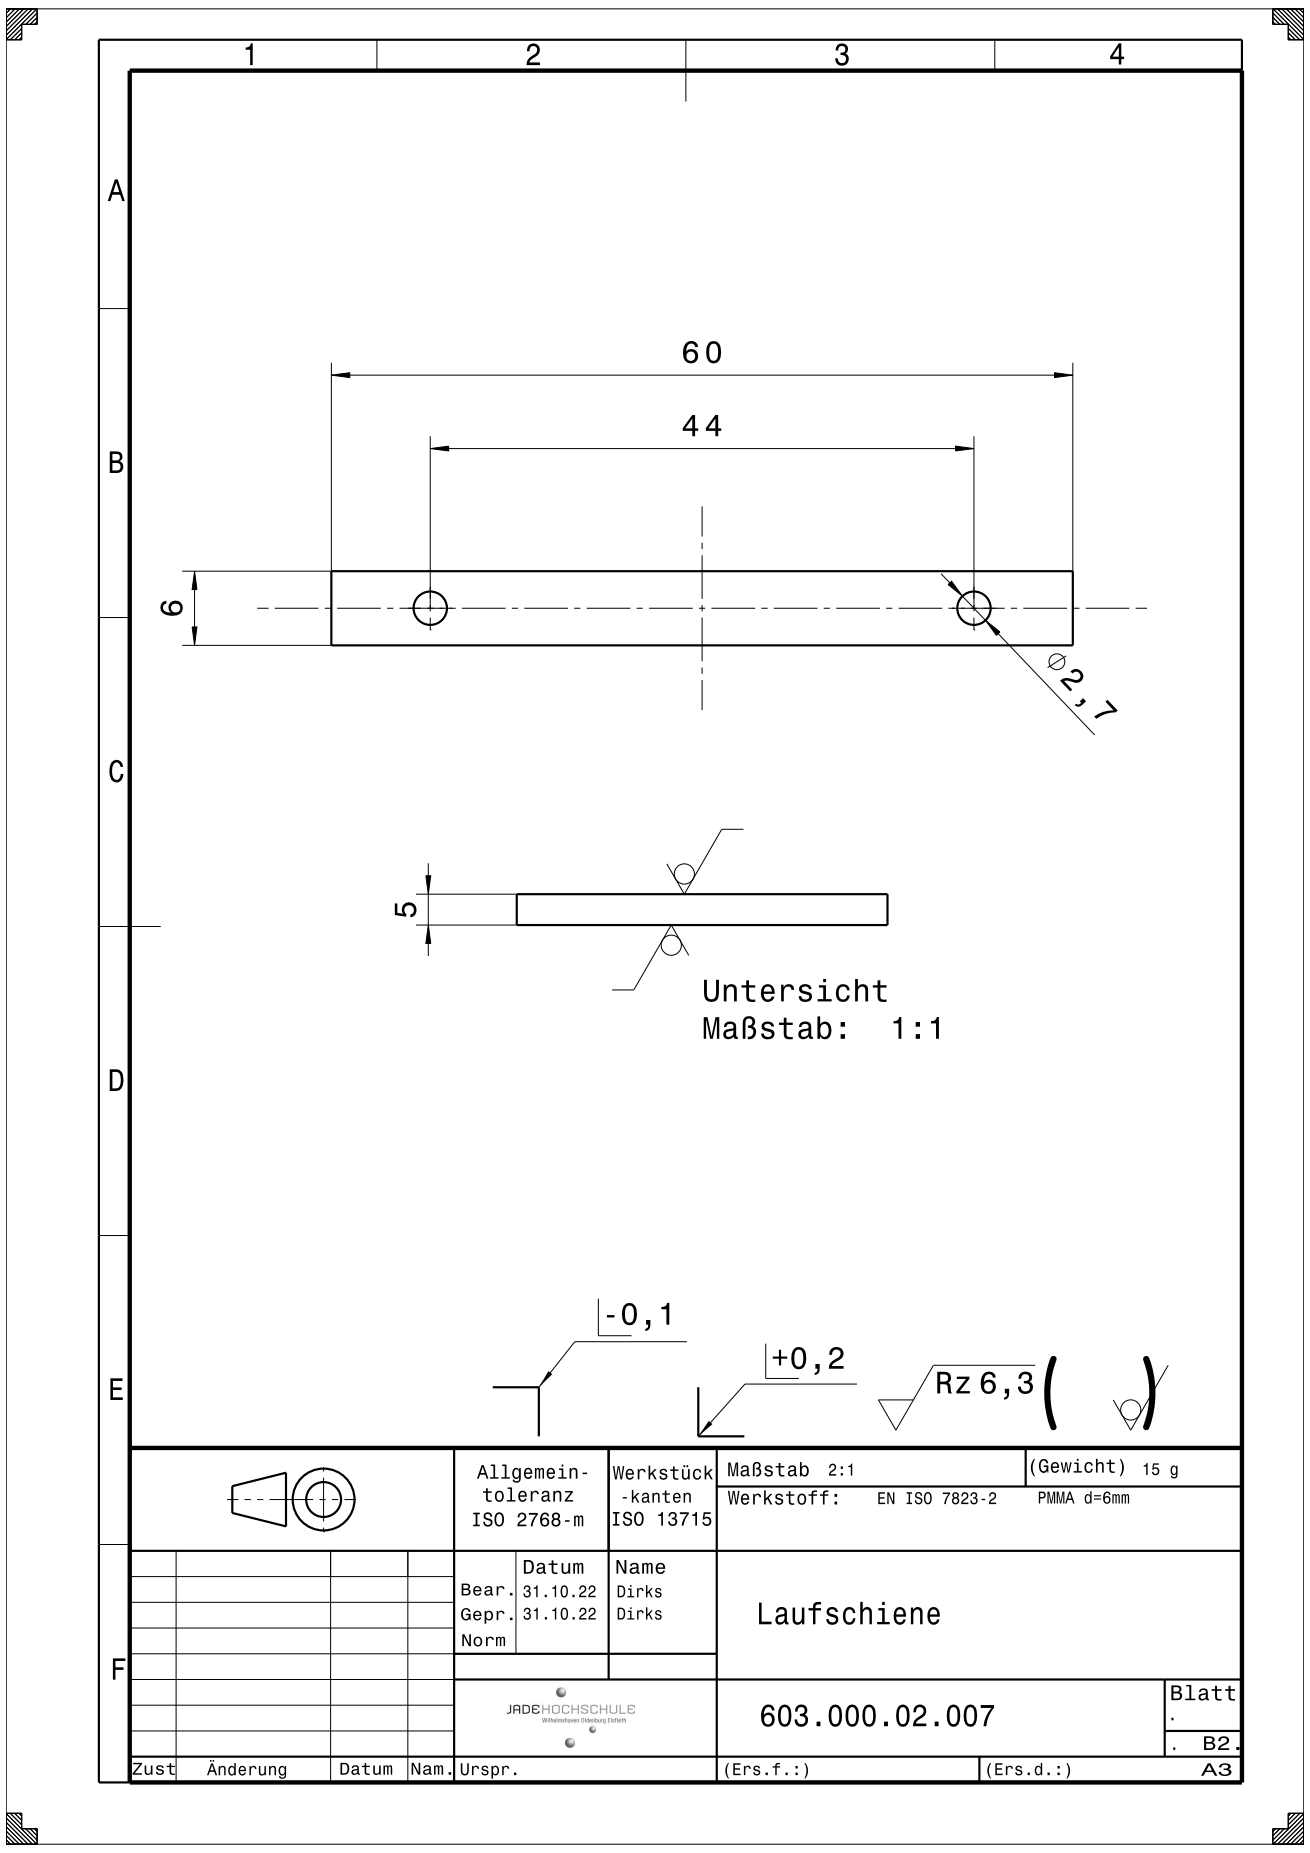
[picture p56: page 1]
