jamadir/Komplexlabor/CATIA/603.000.02.000_Aufhaengung/PDF-Zeichnungen/603.000.02.000_Aufhängung.pdf

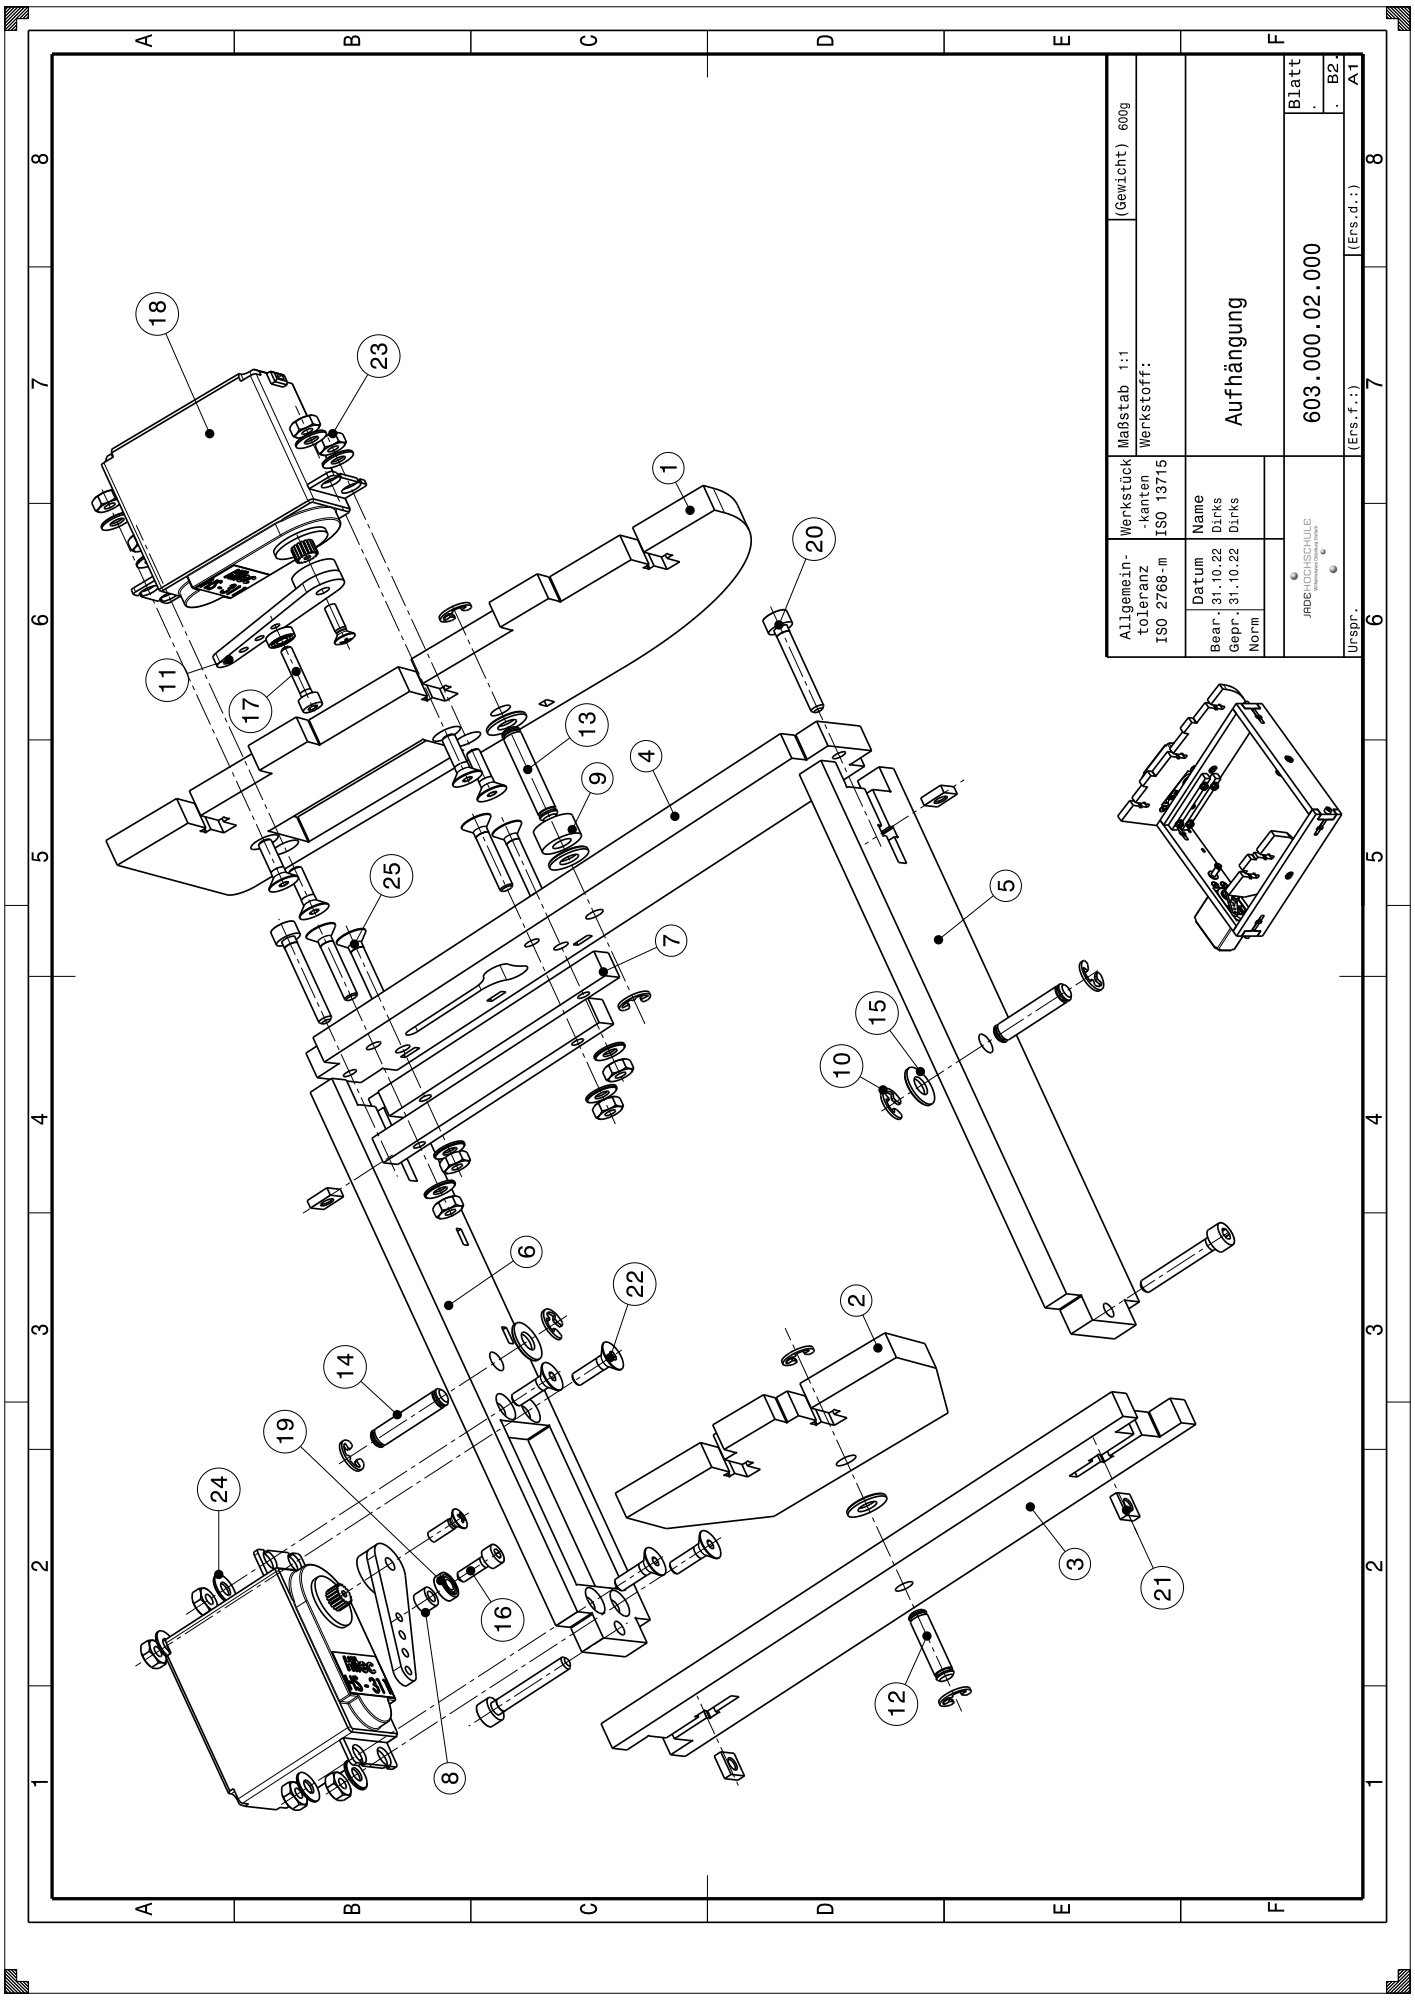
[picture p57: page 1]
