jamadir/Komplexlabor/CATIA/603.000.02.000_Aufhaengung/PDF-Zeichnungen/603.000.02.000_Zusammengebaut.pdf

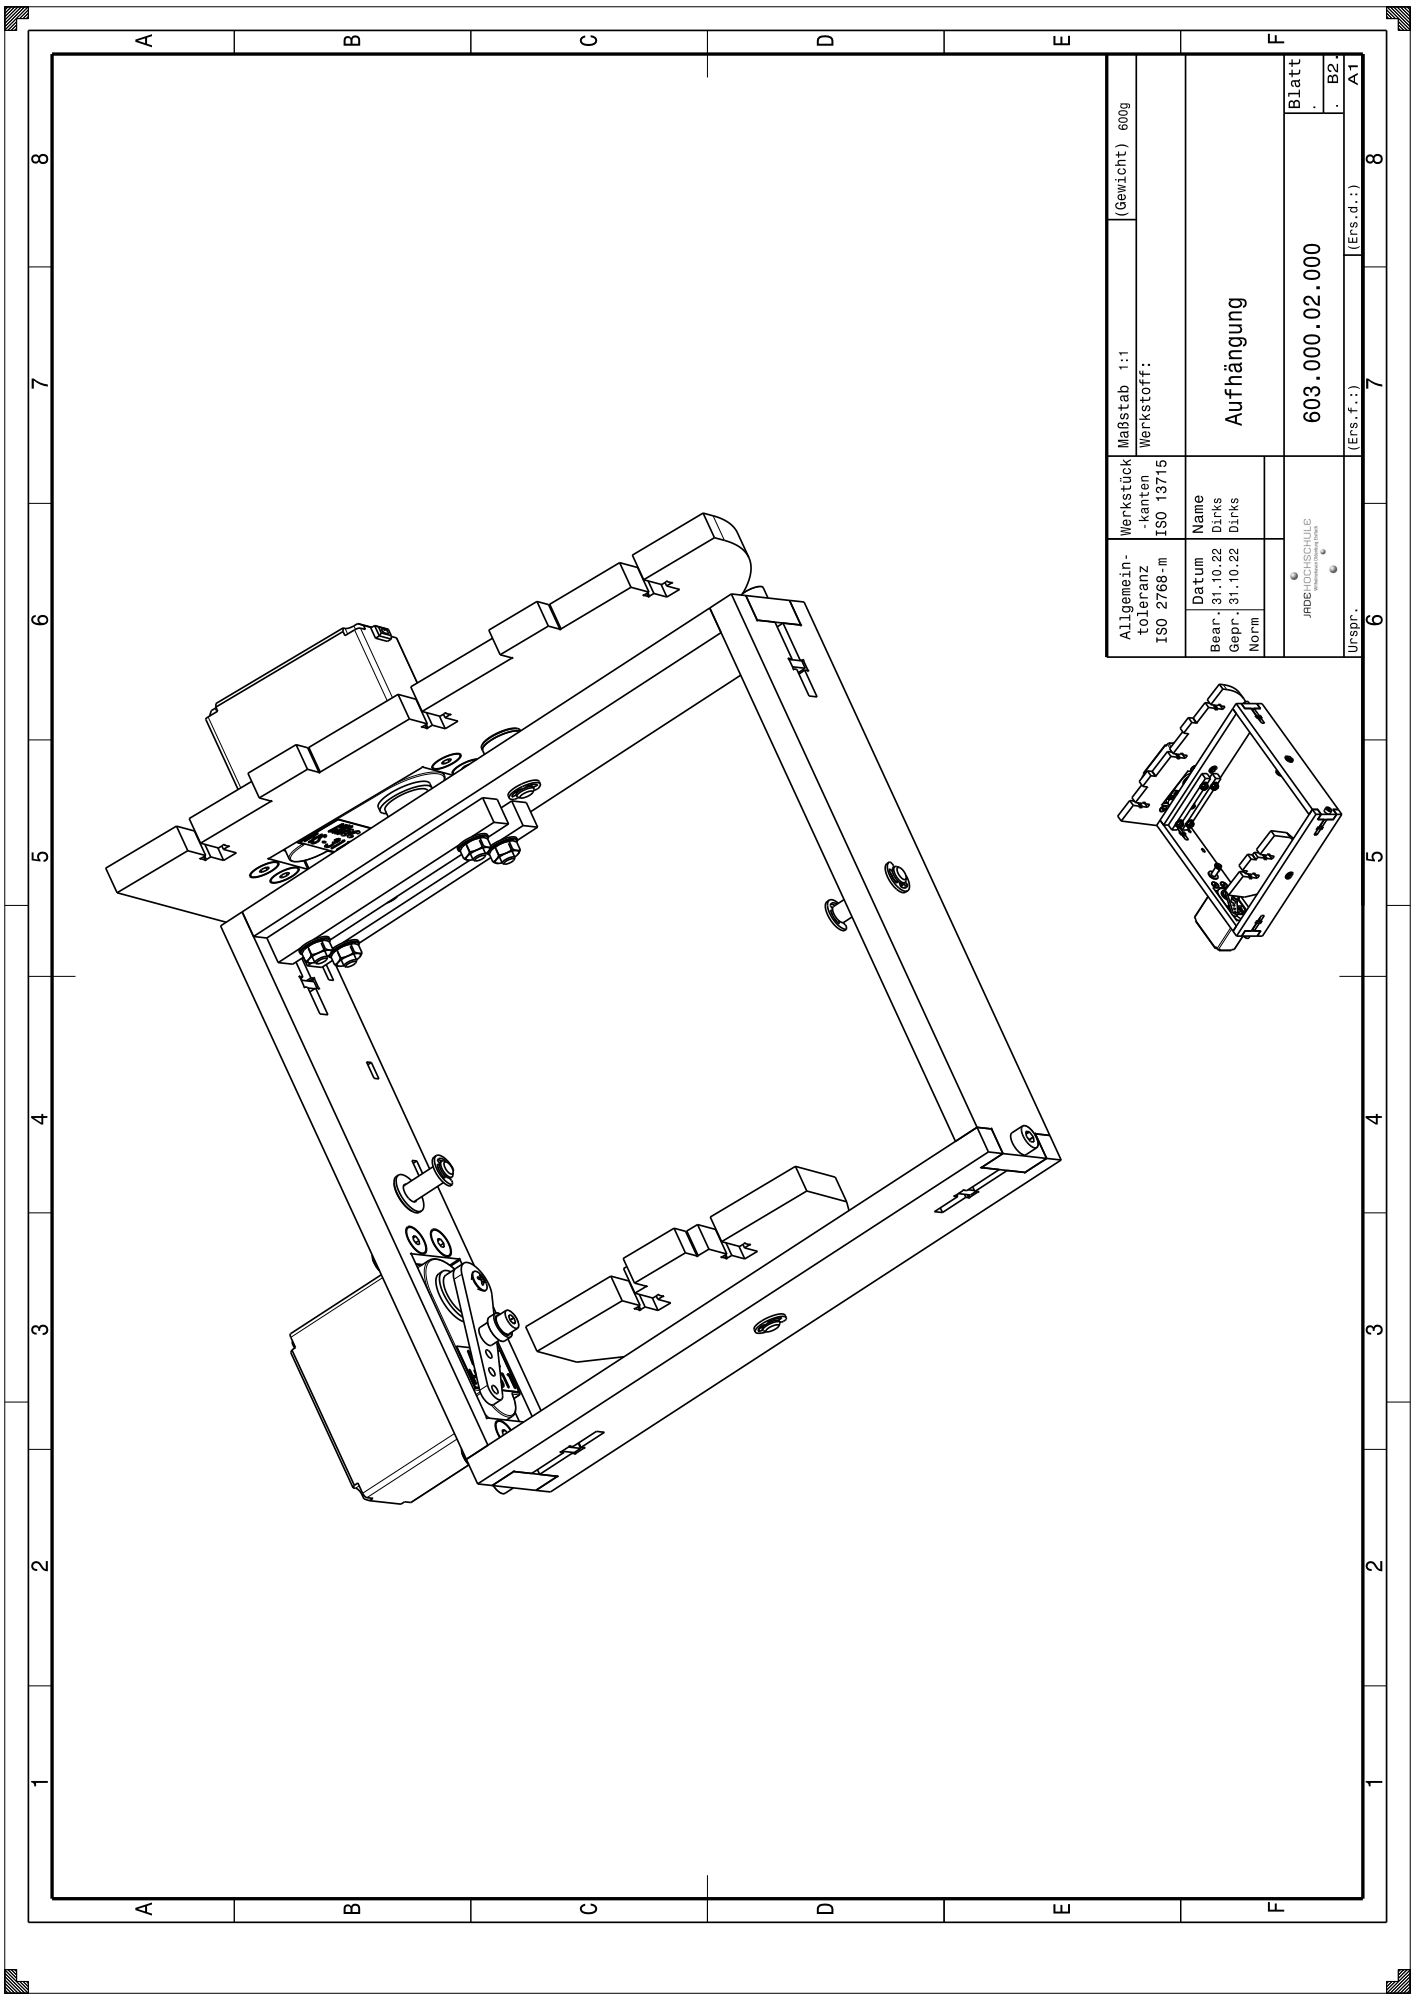
[picture p58: page 1]
