jamadir/Komplexlabor/CATIA/603.000.02.000_Aufhaengung/PDF-Zeichnungen/603.000.02.001_Aufhängung_1.pdf

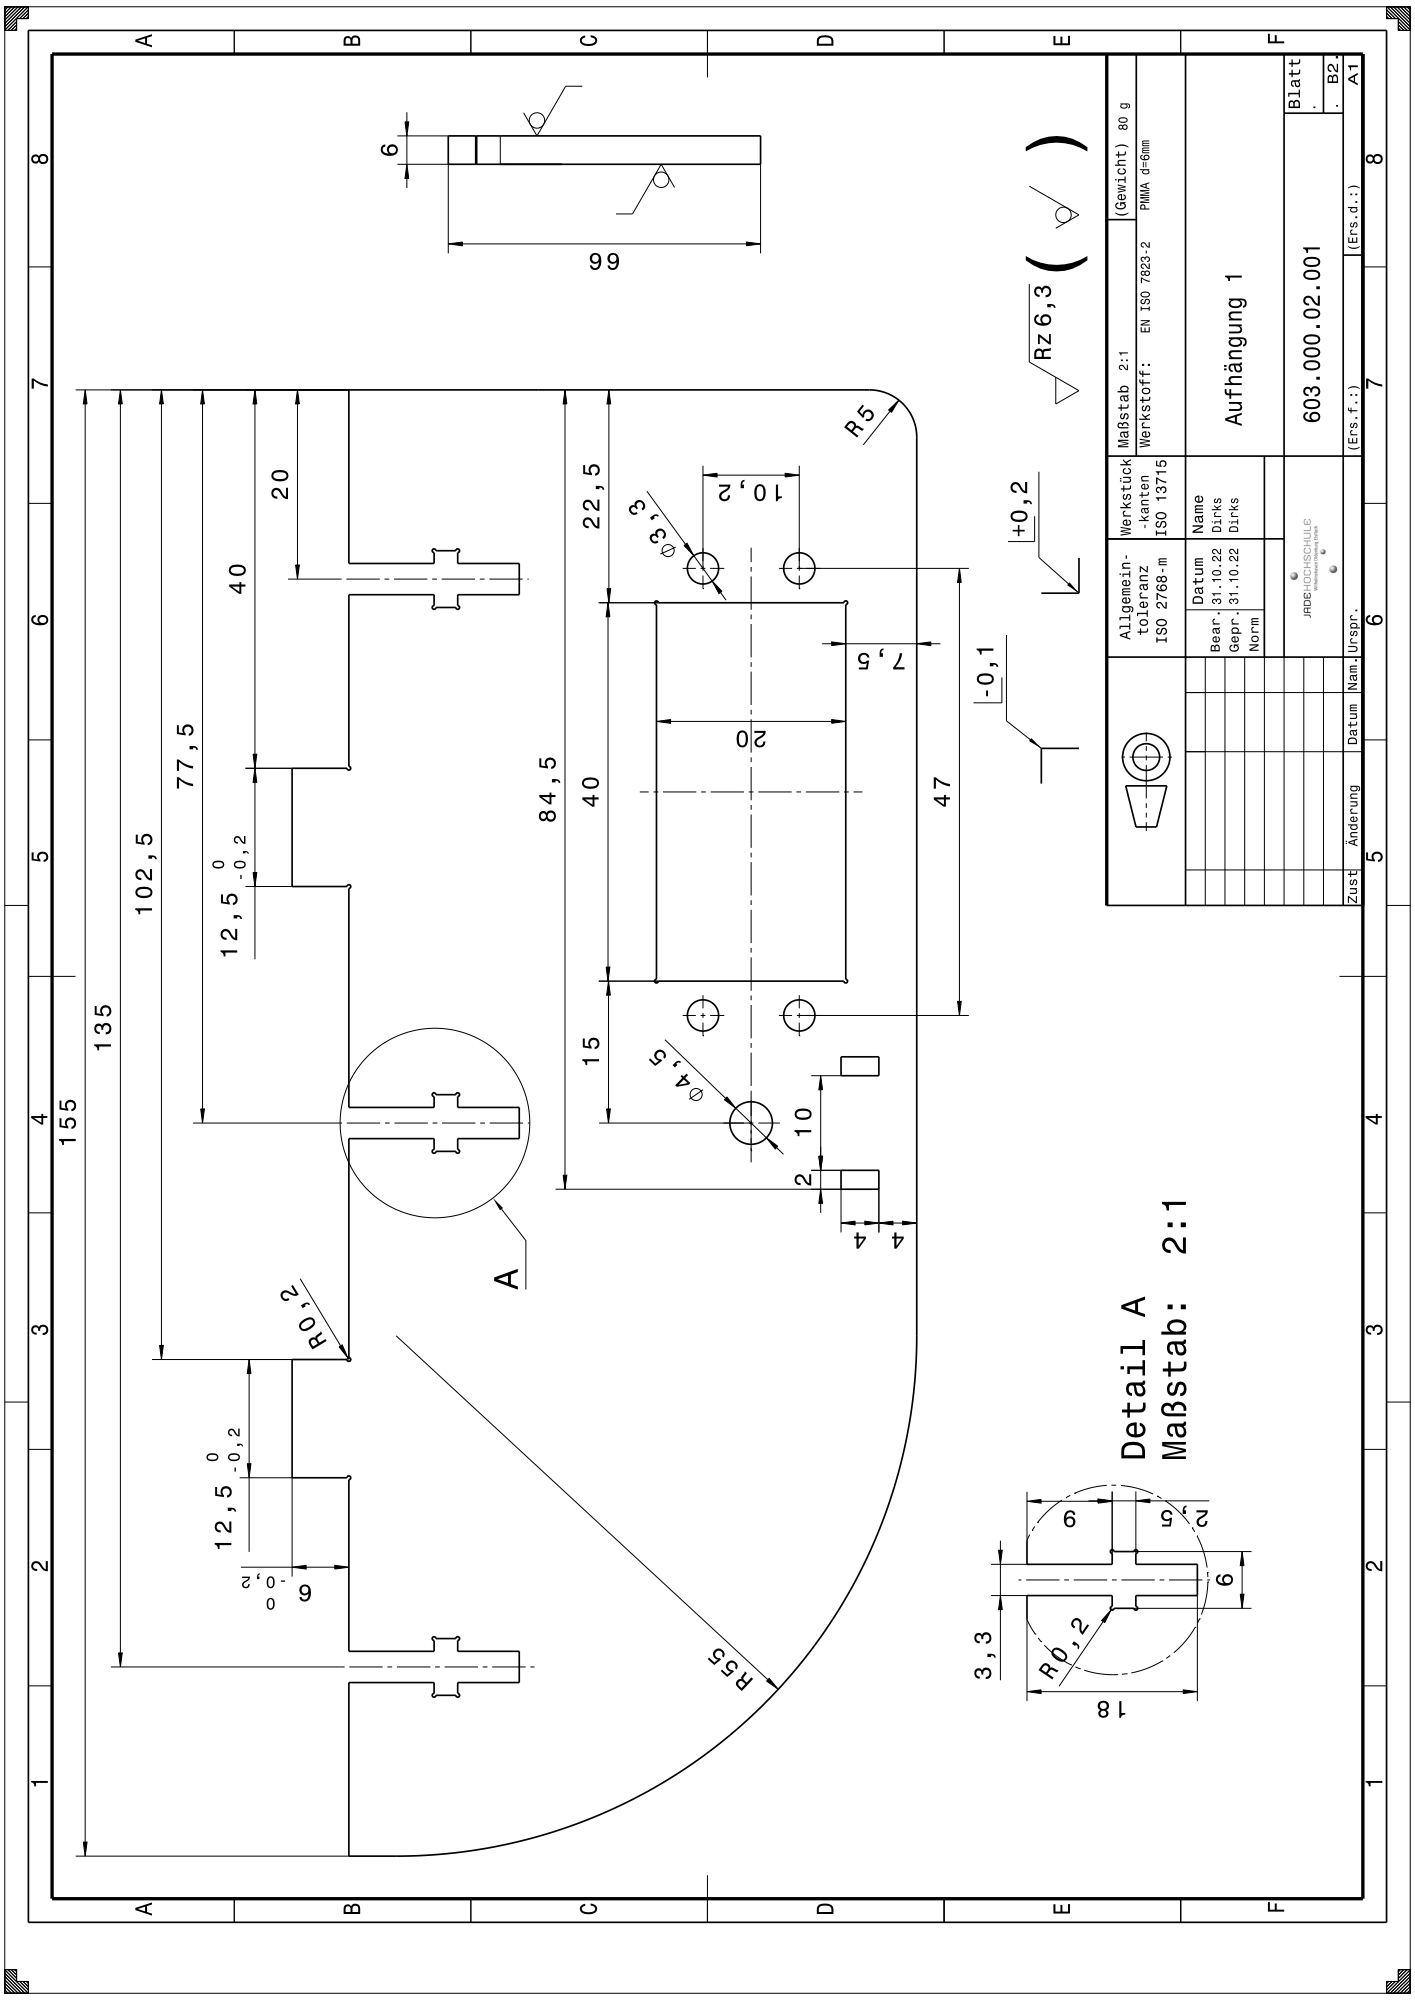
[picture p59: page 1]
