jamadir/Komplexlabor/CATIA/603.000.02.000_Aufhaengung/PDF-Zeichnungen/603.000.02.002_Aufhängung_2.pdf

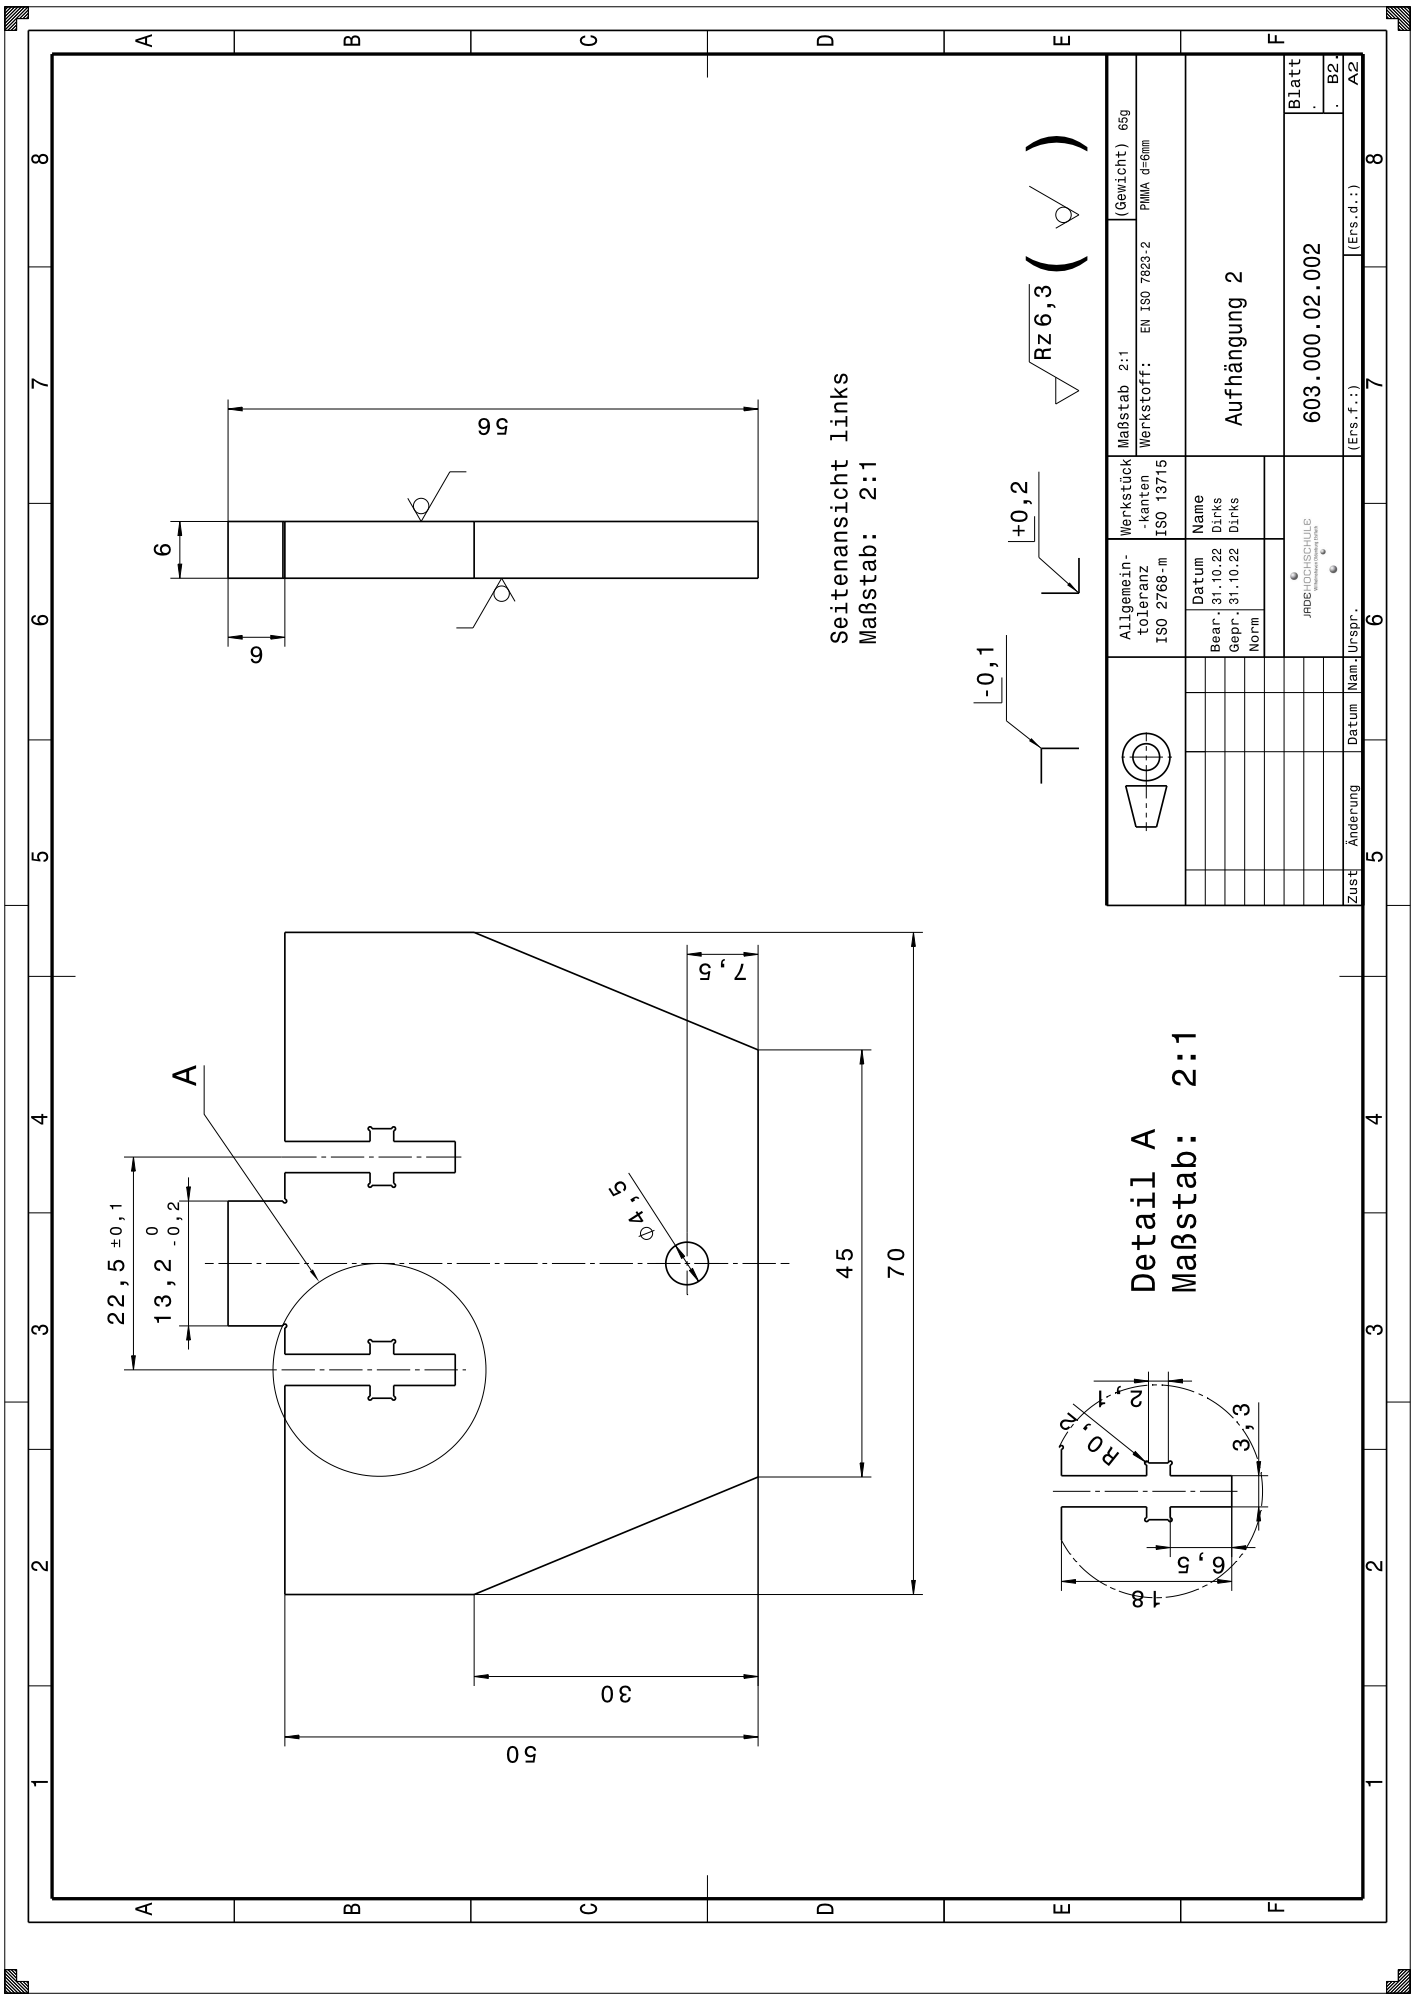
[picture p60: page 1]
