jamadir/Komplexlabor/CATIA/603.000.02.000_Aufhaengung/PDF-Zeichnungen/603.000.02.003_Rahmen_1_1.pdf

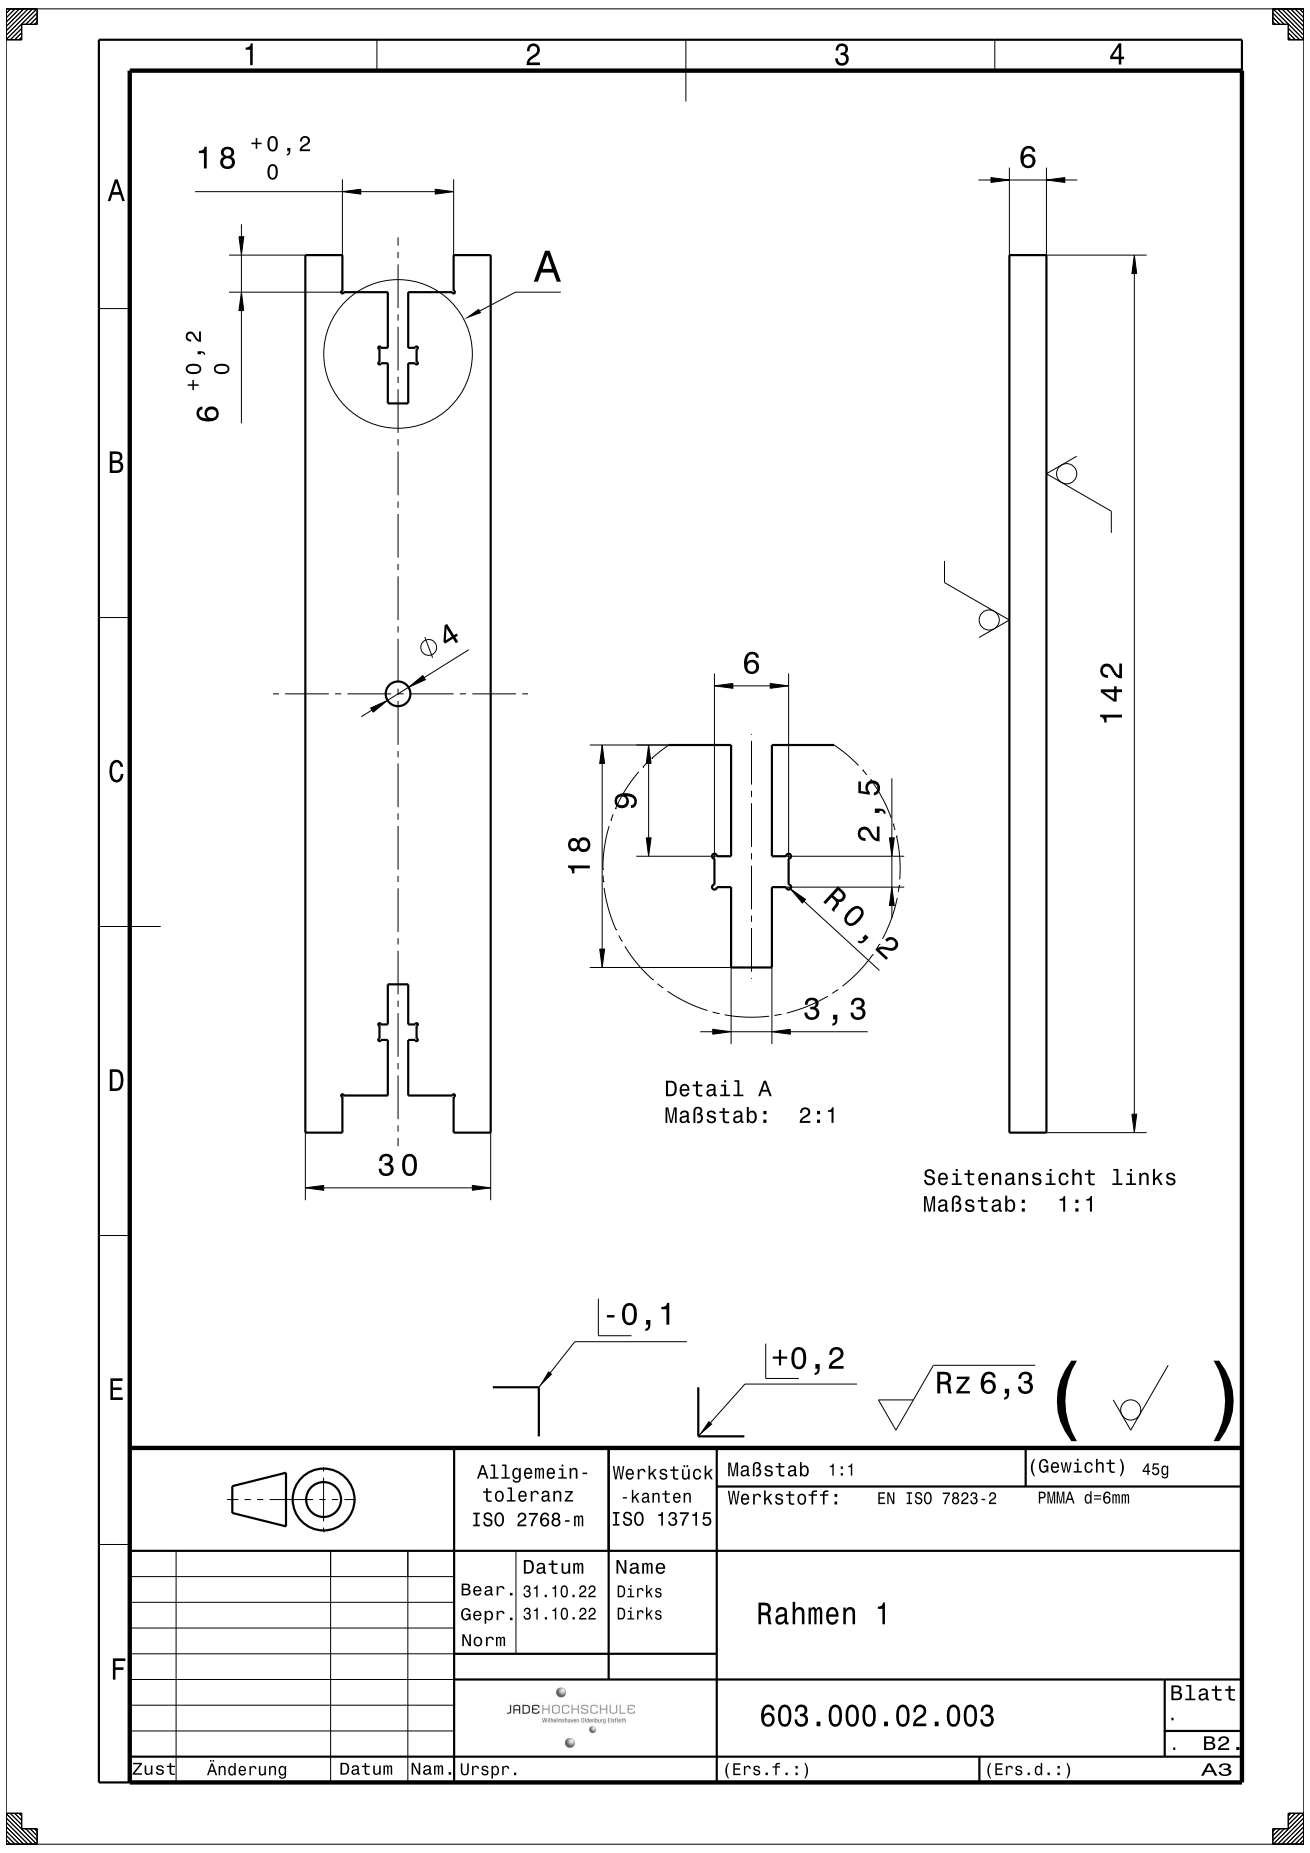
[picture p61: page 1]
