jamadir/Komplexlabor/CATIA/603.000.02.000_Aufhaengung/PDF-Zeichnungen/603.000.02.004_Rahmen_1_2.pdf

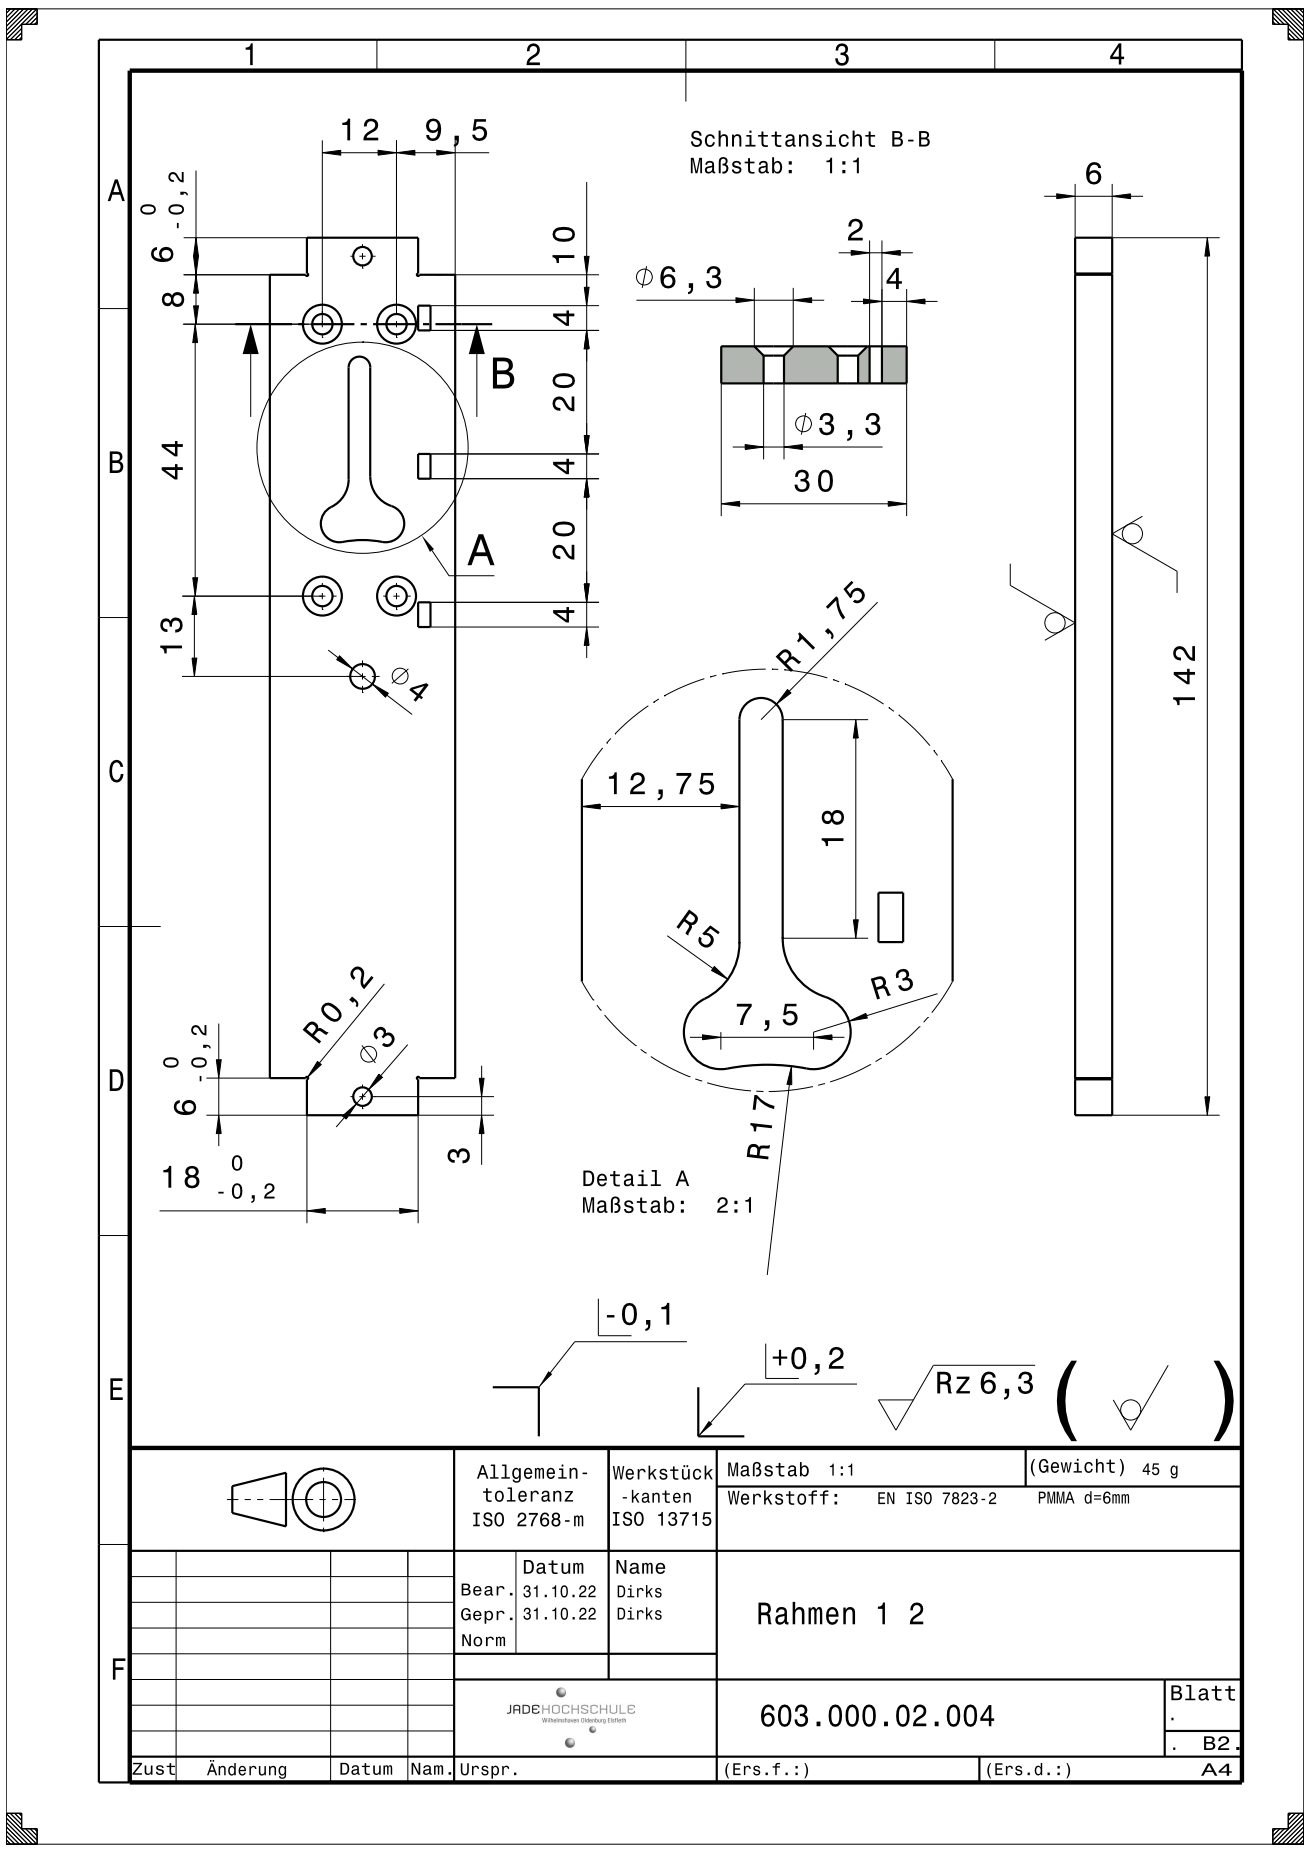
[picture p62: page 1]
