jamadir/Komplexlabor/CATIA/603.000.02.000_Aufhaengung/PDF-Zeichnungen/603.000.02.005_Rahmen_2_1.pdf

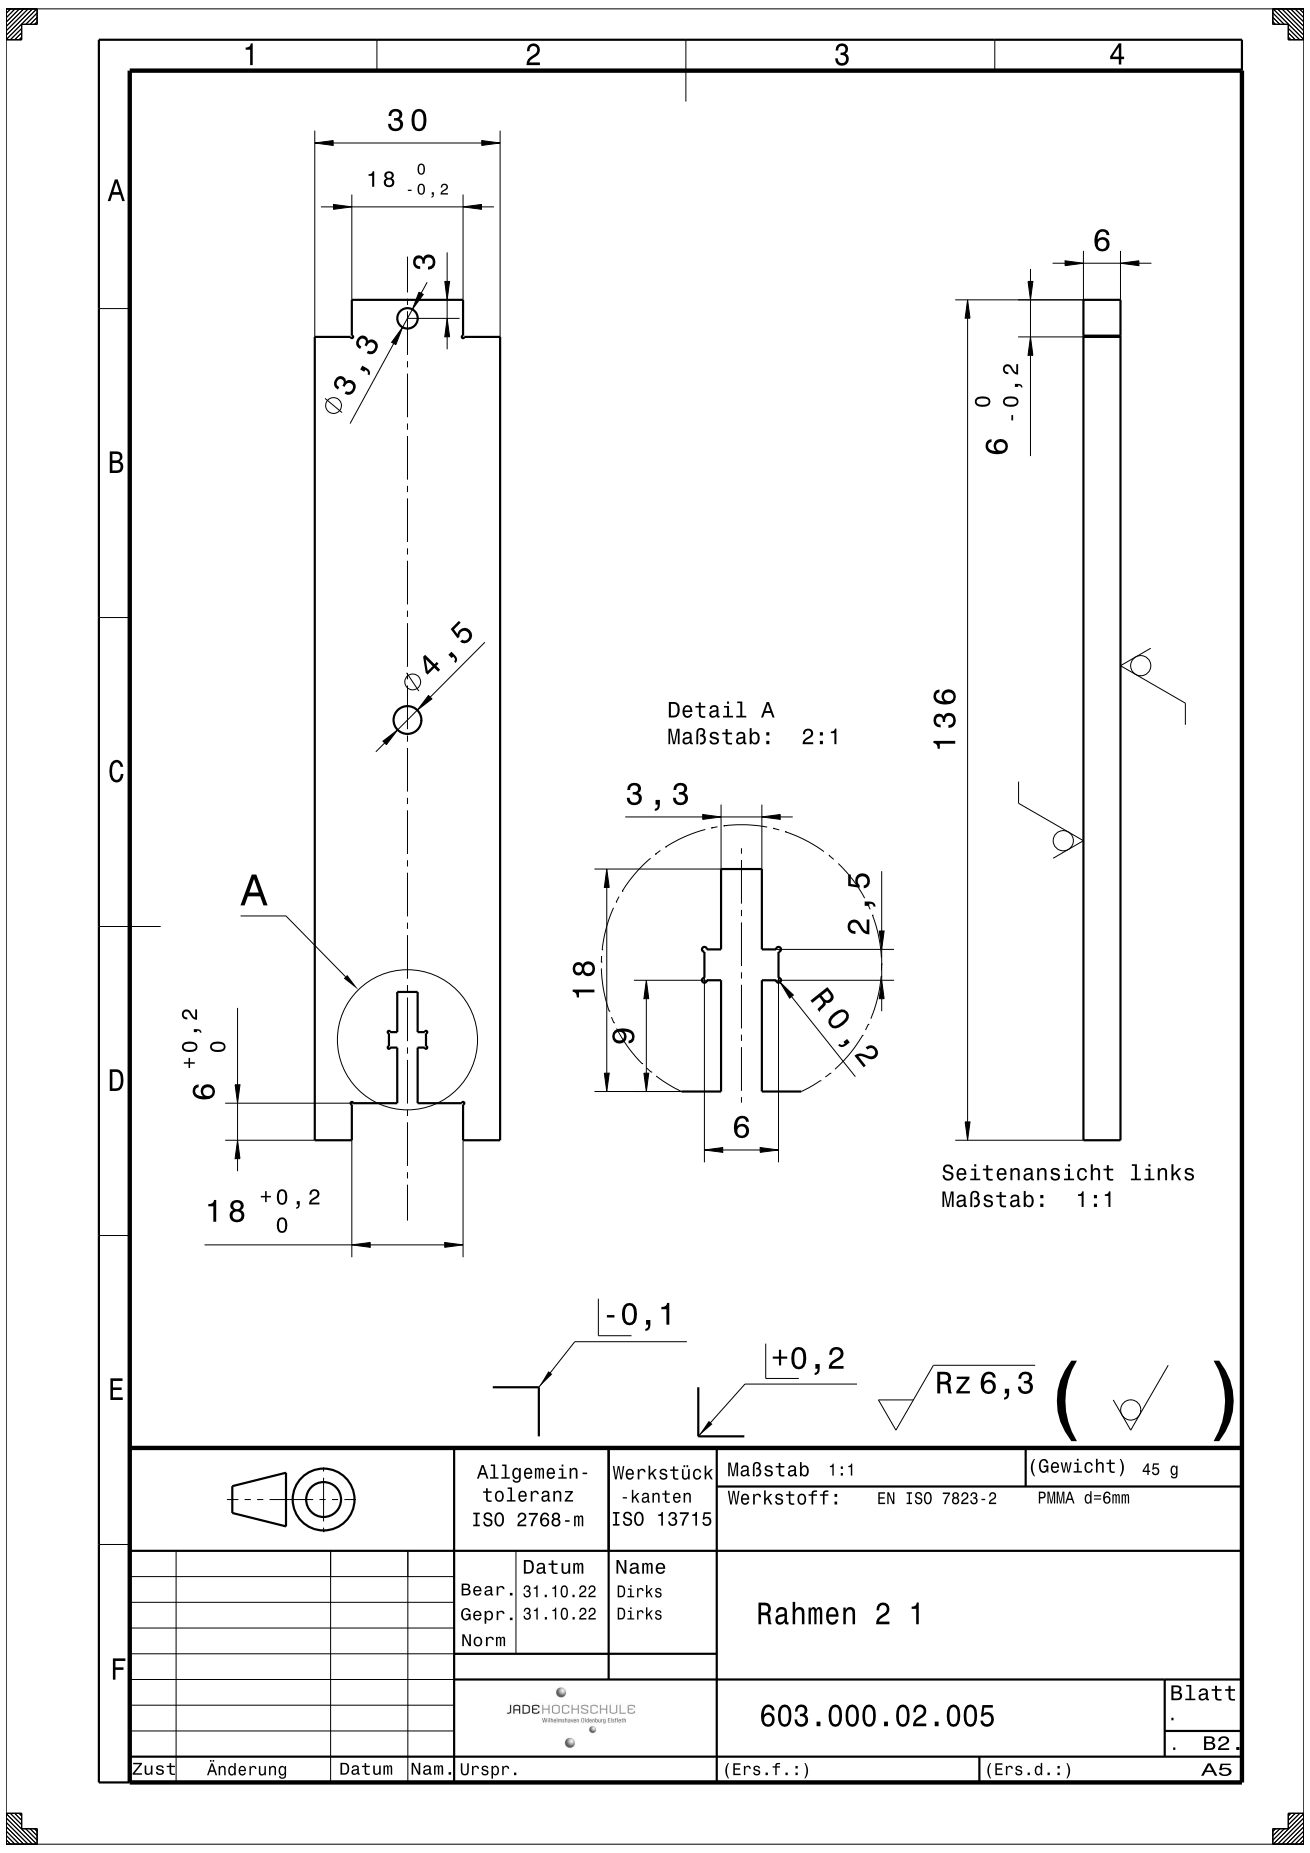
[picture p63: page 1]
