jamadir/Komplexlabor/CATIA/603.000.02.000_Aufhaengung/PDF-Zeichnungen/603.000.02.006_Rahmen_2_2.pdf

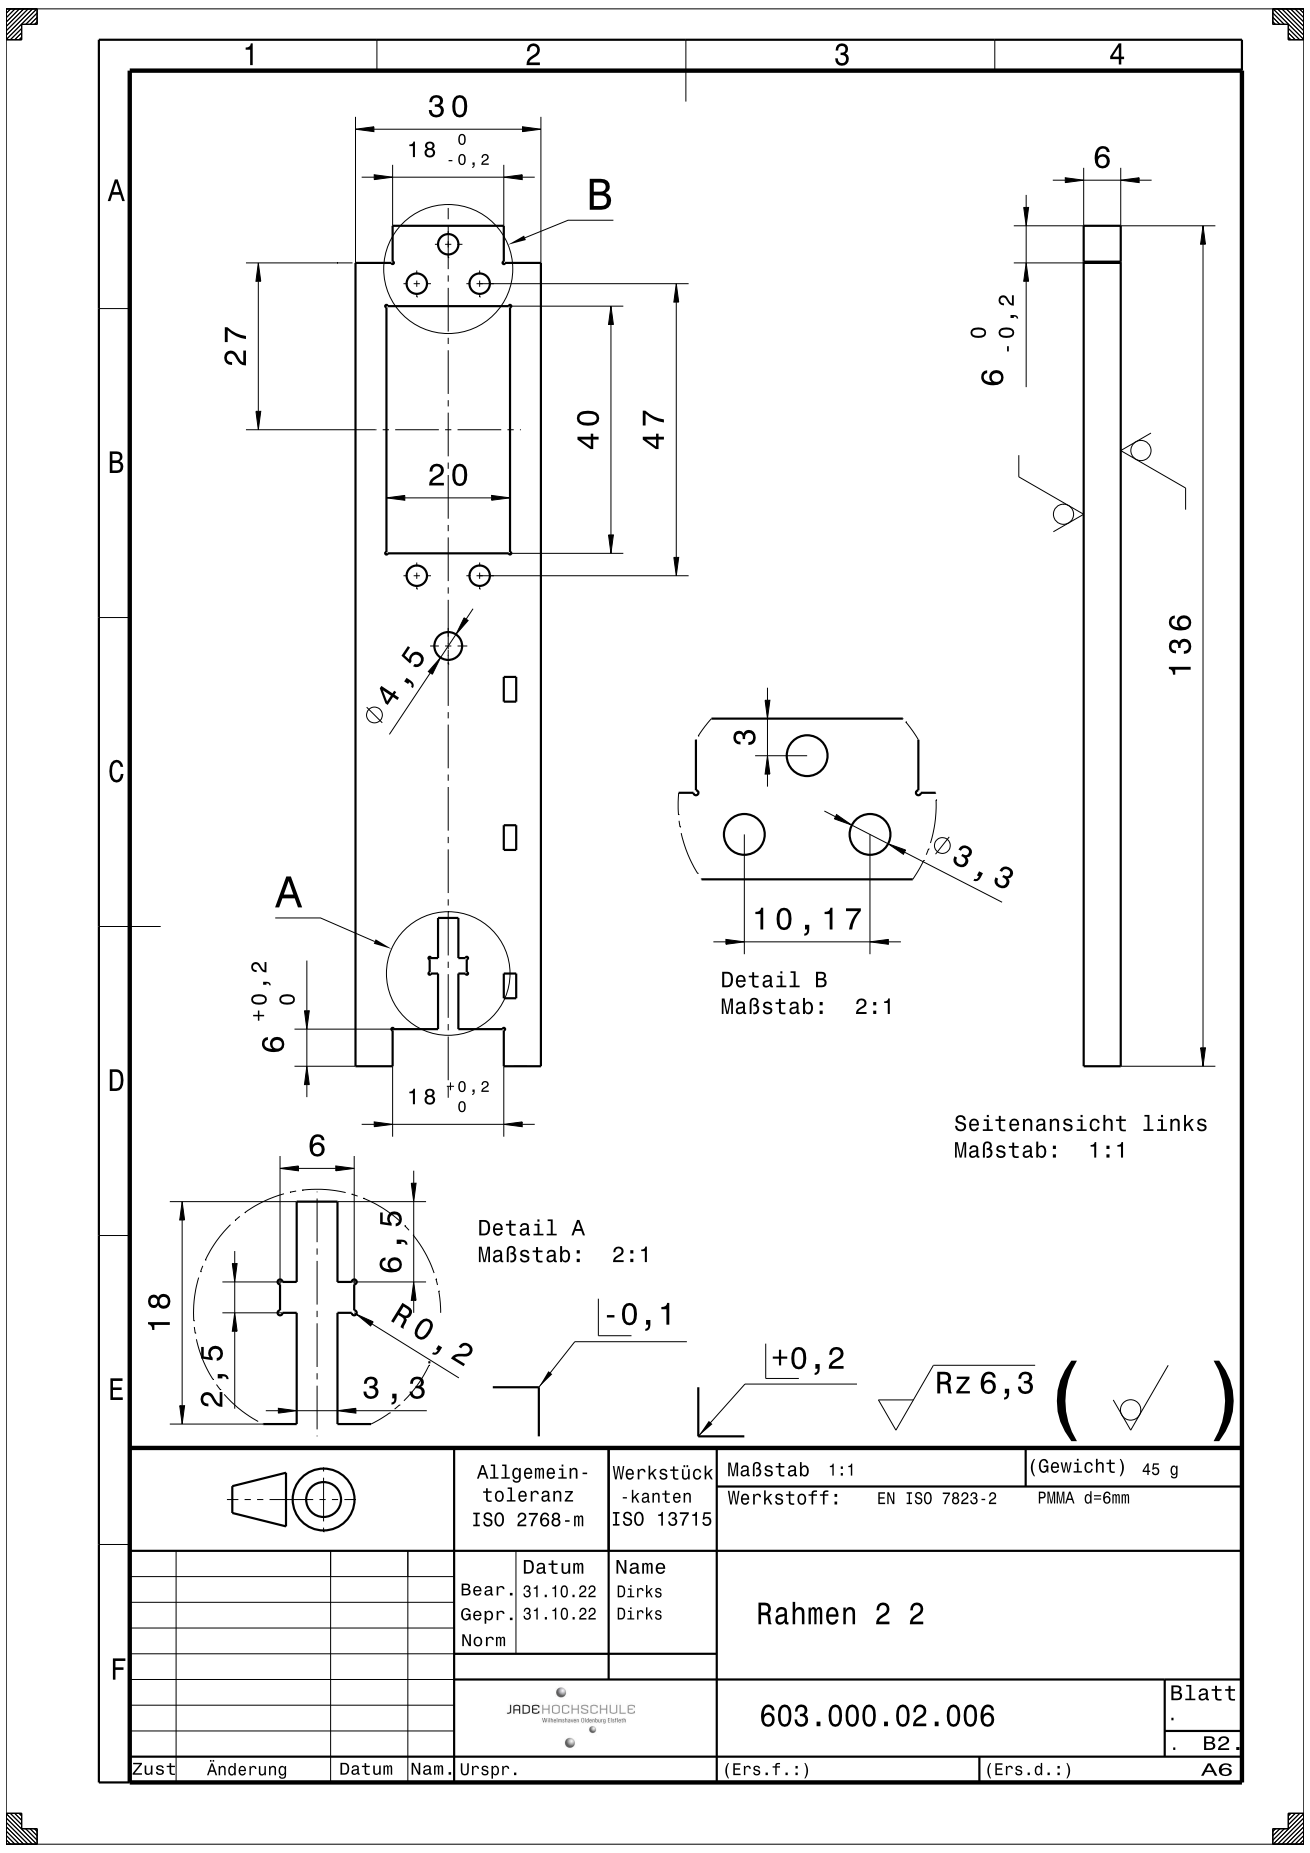
[picture p64: page 1]
