jamadir/Komplexlabor/CATIA/603.000.02.000_Aufhaengung/PDF-Zeichnungen/603.000.02.008_Distanzstück.pdf

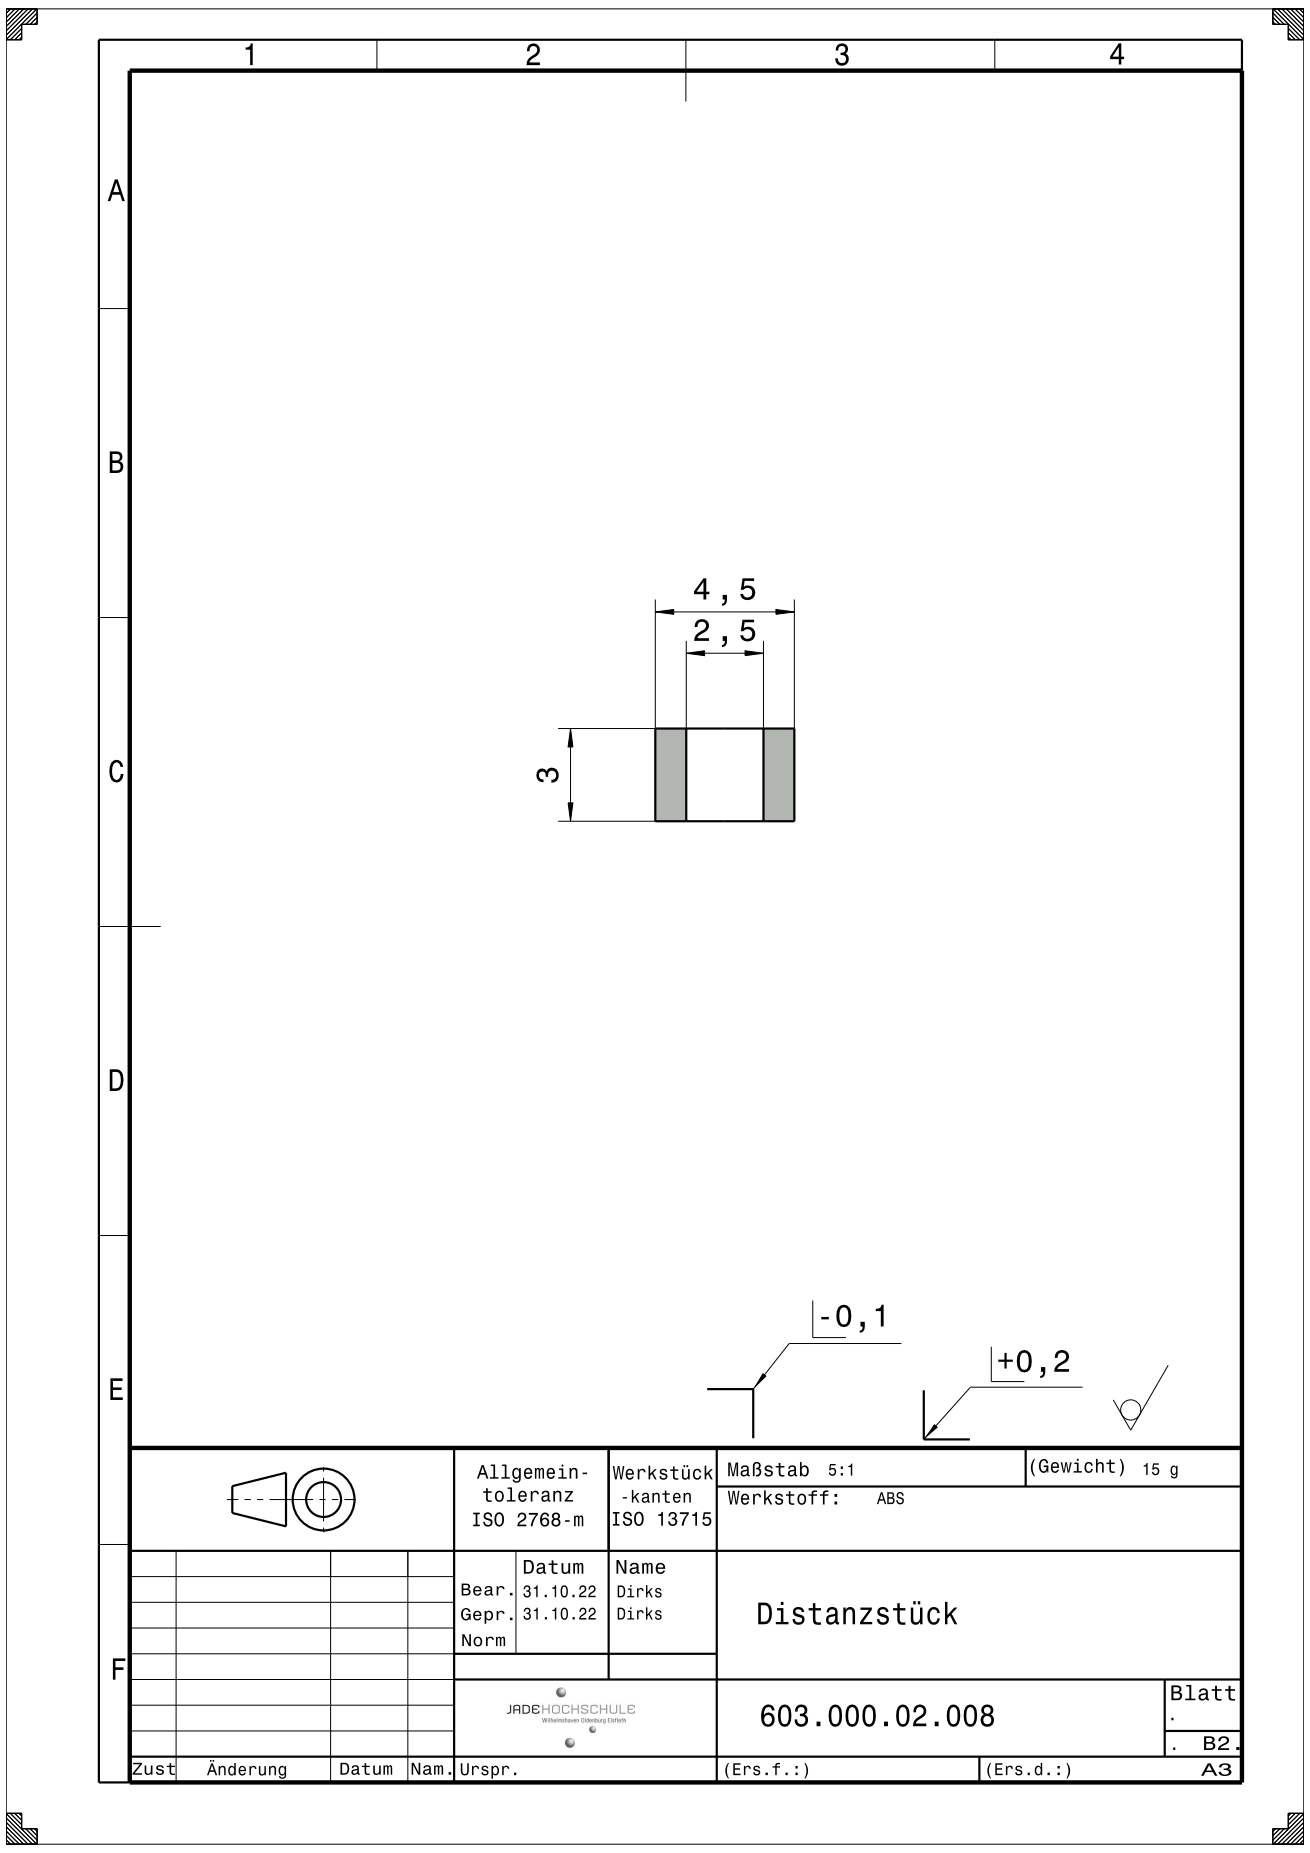
[picture p65: page 1]
