jamadir/Komplexlabor/CATIA/603.000.02.000_Aufhaengung/PDF-Zeichnungen/603.000.02.009_Distanzstück.pdf

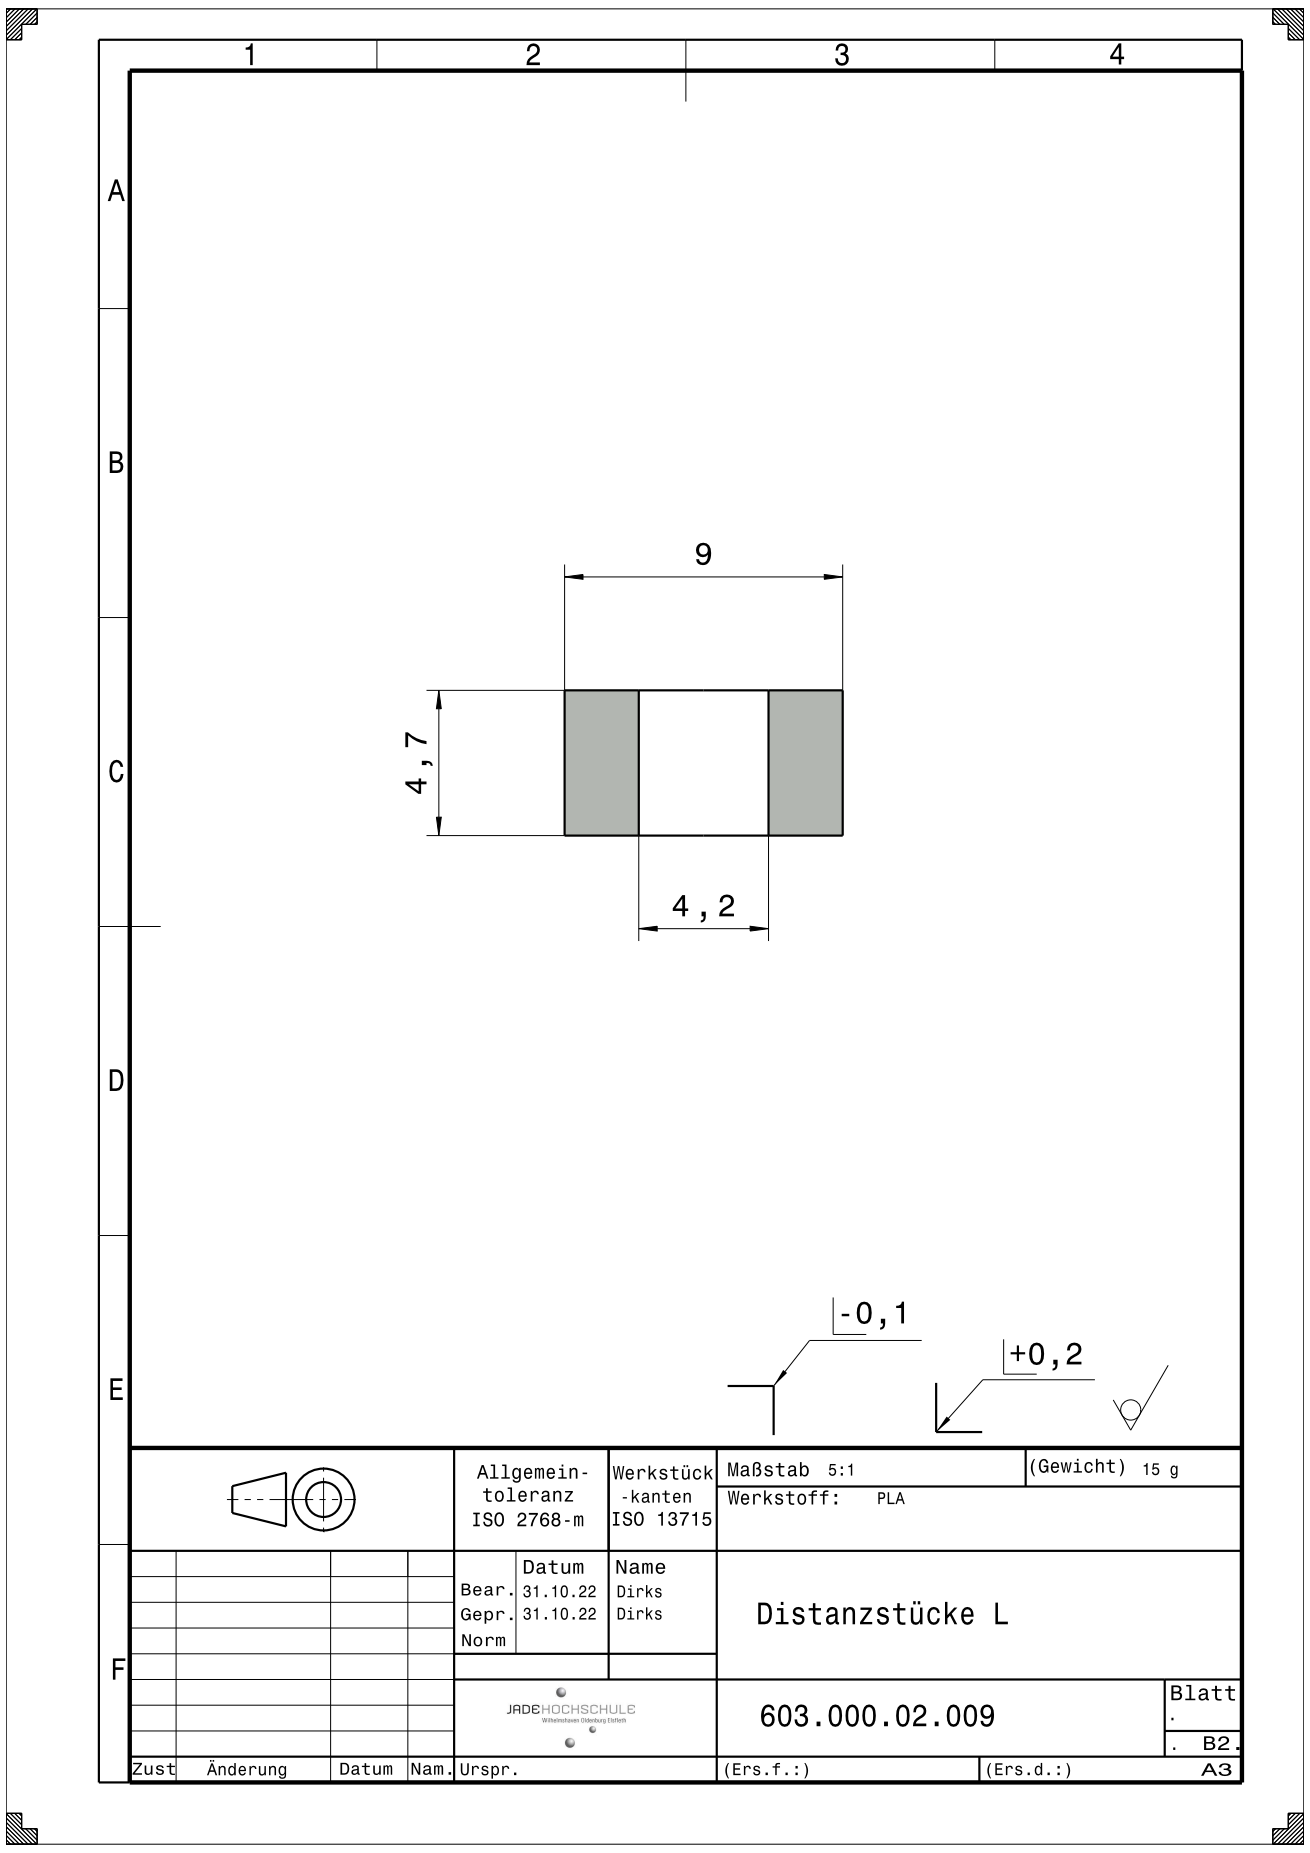
[picture p66: page 1]
