jamadir/Komplexlabor/CATIA/603.000.02.000_Aufhaengung/PDF-Zeichnungen/603.000.02.007_Laufschiene.pdf

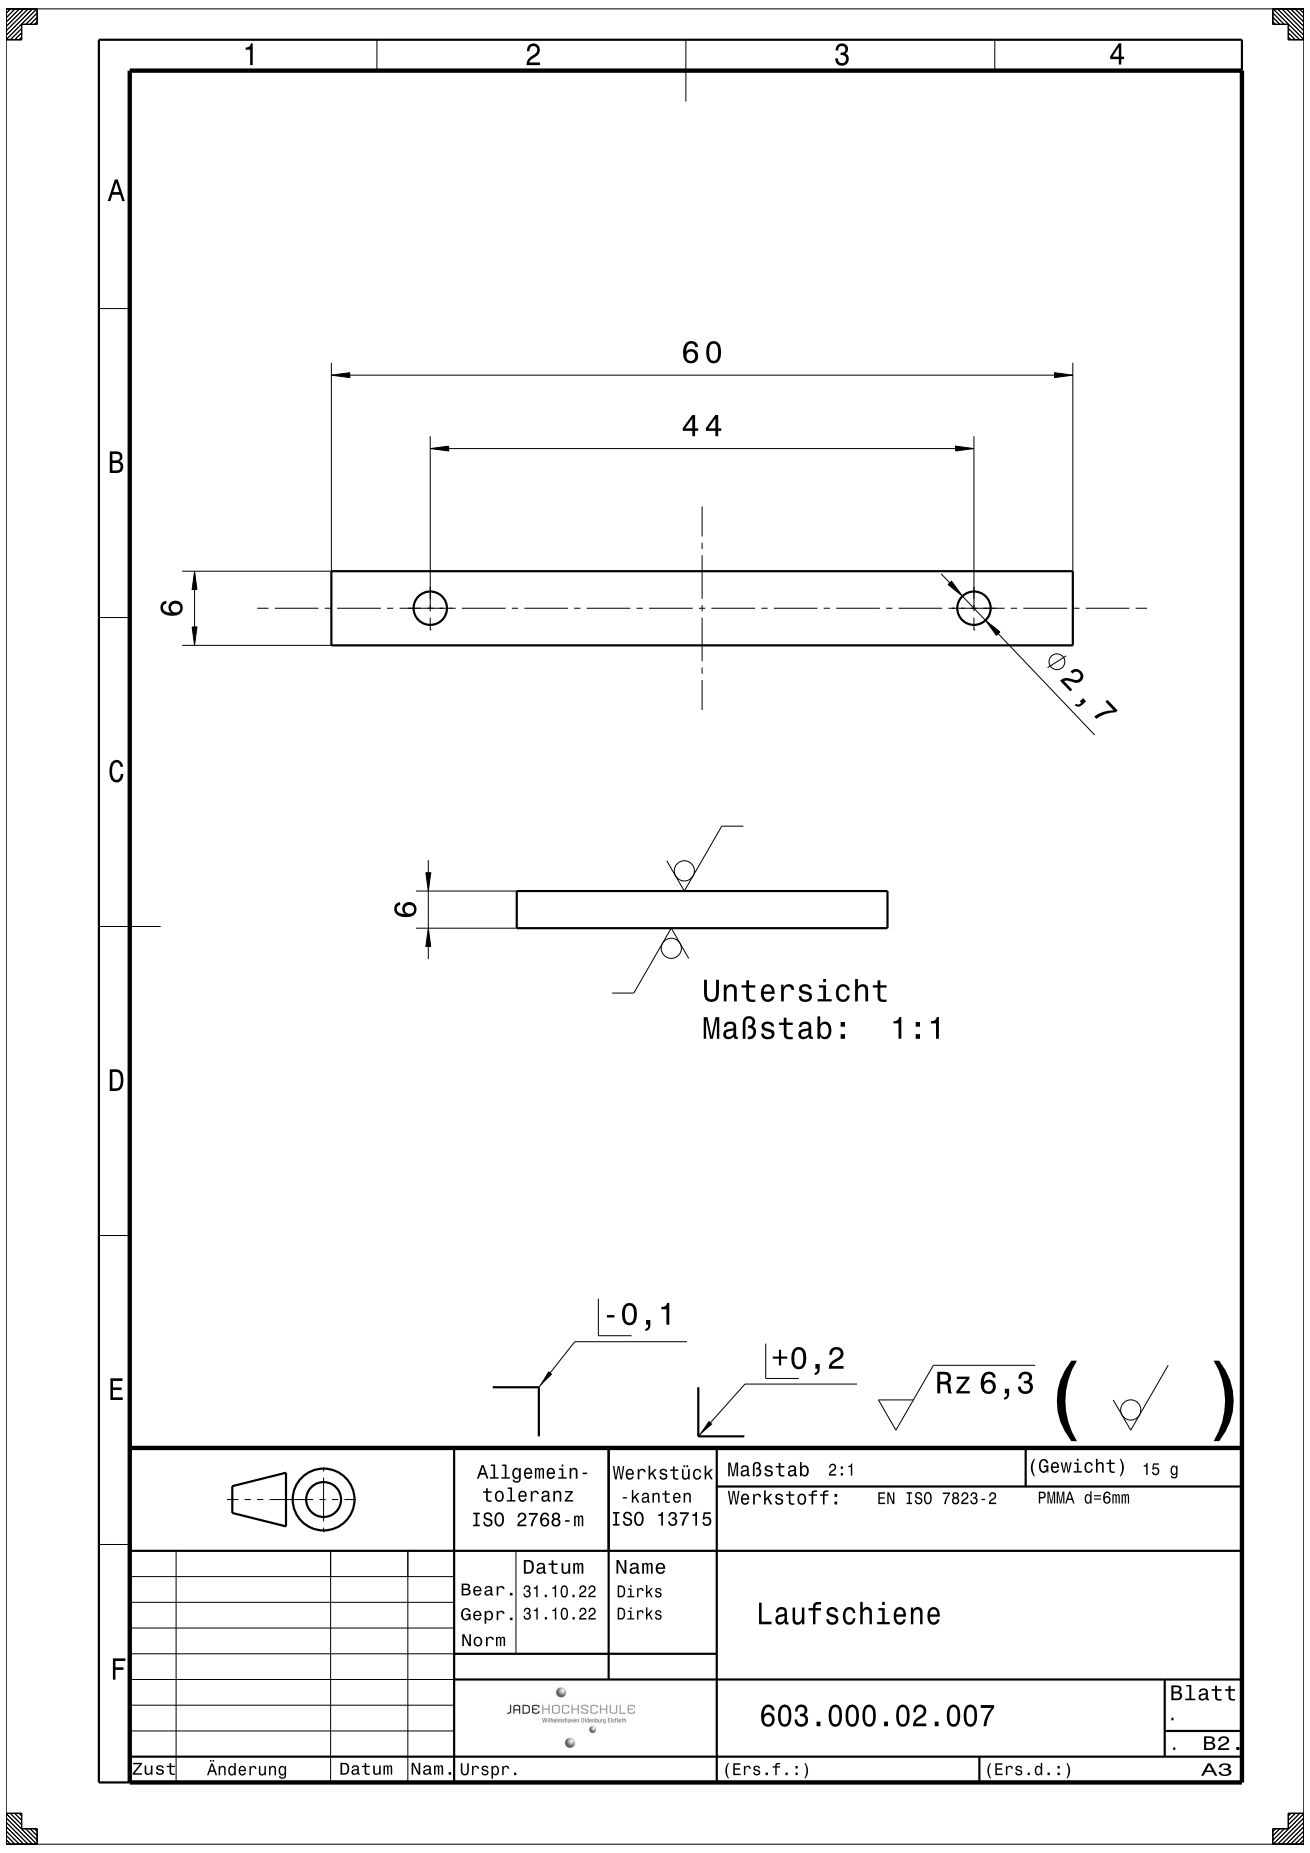
[picture p67: page 1]
