jamadir/Komplexlabor/(commit log)

2022-10-03 Varianten Motor Lösungsfindung
    [Nutzwertanalyse.xlsx]
2022-10-03 Update Varianten Motor.pdf
2022-10-06 Prototyp modell der aufhängung
    Verwendet servos mit Kurven zur ansteuerung
    [Labyrinth.CATPart, Labyrinthspiel.CATProduct, Part4.CATPart, Rahmen aussen.CATPart]
2022-10-08 Inner outer Rahmen
    [Labyrinthspiel.CATProduct, Rahmen aussen aussen.CATPart, Rahmen aussen.CATPart, labyrinth.stl, laufschiene.stl]
2022-10-09 Fertiger Prototyp
    [Labyrinthspiel.CATProduct, Rahmen aussen aussen.CATPart, Rahmen aussen.CATPart, bodengestell.CATPart, gestell.stl, rahmen aussen ausseb.stl, rahmen aussen innen.stl]
2022-10-10 Servo + Kurve Variante Hinzugefügt
    [Nutzwertanalyse.xlsx]
2022-10-11 Baugruppe Labyrinth
    [ANSI_B27_7M_3CM1_4_STEEL_EXTERNAL_RETAINING_E_RING.CATPart, Abdeckplatte.CATPart, Auffangplatte.CATPart, Kugel.CATPart, Labyrinth.CATProduct, Labyrinthplatte.CATPart, Lagereinsatz mit Laufschiene.CATPart, Lagereinsatz.CATPart]
2022-10-13 Innerer Rahmen
    [Aufhaengung und Servos.CATProduct, Labyrinthspiel.CATProduct, Lagereinsatz mit Laufschiene.CATPart, Rahmen innen.CATPart]
2022-10-16 Vollständige aufhaengung
    [Aufhaengung aussen.CATPart, Aufhaengung und Servos.CATProduct, Fuehrung.2.CATPart, Labyrinth.CATProduct, Rahmen innen.CATPart, Servo.CATPart, Servo2.CATPart]
2022-10-17 Gehäusedeckel hinzugefügt
    [Aufhaengung und Servos.CATProduct, Deckel.1.CATPart, Gehause.CATProduct]
2022-10-18 Hebelarm hinzugefügt
    [Armkonstruktion.CATProduct, Aufhaengung und Servos.CATProduct, Deckel.1.CATPart, Fuehrung.2.CATPart, Gehause.CATProduct, Hebelarm.CATPart, Kugellager.CATPart, Labyrinth.CATProduct]
2022-10-18 CATparts der Kaufteile
    [GY521.CATPart, Hitec Servo Motor HS-311.CATPart]
2022-10-18 Neue Teile (nicht fertig)
    [Aufhaengung_1.CATPart, Aufhaengung_2.CATPart, Gehaeuse.CATProduct, Gehaeuse_Bodenplatte.CATPart, Gehaeuse_Deckel.CATPart, Gehaeuse_Seitenplatte_1.CATPart, Gehaeuse_Seitenplatte_2.CATPart, Gehaeuse_Seitenplatte_3.CATPart]
2022-10-18 Aktualisierung der CATProdukte
    [603.000.00.000_Kugellabyrinth.CATProduct, Labyrinth.CATProduct, Rahmen.CATProduct]
2022-10-18 Stückliste Gesamt
    [Stückliste Kugellabyrinth.xls]
2022-10-18 Update Stückliste Kugellabyrinth.xls
    [Stückliste Kugellabyrinth.xls]
2022-10-24 Hinzufügen der Platinen
2022-10-24 Vorbote des Updates
    [603.000.00.000_Kugellabyrinth.CATProduct, ANSI_B27_7M_3CM1_4_STEEL_EXTERNAL_RETAINING_E_RING.CATPart, Abdeckplatte.CATPart, Auffangplatte.CATPart, Aufhaengung_1.CATPart, Distanzstueck.CATPart, Distanzstueck_Lagerung.CATPart, Gehaeuse.CATProduct]
2022-10-25 Update Dienstag Morgen 25.10.2022
    [603.000.00.000_Kugellabyrinth.CATProduct, ANSI_B27_7M_3CM1_4_STEEL_EXTERNAL_RETAINING_E_RING.CATPart, Abdeckplatte.CATPart, Auffangplatte.CATPart, Aufhaengung_1.CATPart, Aufhaengung_2.CATPart, Distanzstueck.CATPart, Distanzstueck_Lagerung.CATPart]
2022-10-25 Stand kurz vor Besprechung
    [603.000.00.000_Kugellabyrinth.CATProduct, Aufhaengung_1.CATPart, Distanzlage_6mm.CATPart, Fernsteuerung.CATProduct, Gehaeuse.CATProduct, Gehaeuse_Deckel.CATPart, Gehaeuse_Seitenplatte_1.CATPart, Grundplatte.CATPart]
2022-10-25 Add Fernbedienung PCB
2022-10-25 Stand Dienstag 25.10.2022
    Bauteile und Freischnitte ergänzt
    [603.000.00.000_Kugellabyrinth.CATProduct, Bananenstecker_rot.CATPart, Bananenstecker_schwarz.CATPart, Gehaeuse_Seitenplatte_4.CATPart, Hirschmann 4 mm Bananenbuchse Lötanschluß.step, Hirschmann 4 mm Bananenbuchse Rot auf 6,3mmx0,8mm.step, Labyrinth.CATProduct, RCA_chassis.STEP]
2022-10-30 Platine Fernsteuerung
    Platine für Fernsteuerung als CAT-Part
    [COMPOUND(1).CATPart, COMPOUND(10).CATPart, COMPOUND(11).CATPart, COMPOUND(12).CATPart, COMPOUND(2).CATPart, COMPOUND(3).CATPart, COMPOUND(4).CATPart, COMPOUND(6).CATPart]
2022-10-30 Fernsteuerung konstruiert
    [Abdeckplatte.CATPart, COMPOUND(1).CATPart, COMPOUND(4).CATPart, Distanzlage_6mm.CATPart, Fernsteuerung.CATProduct, GY521.CATPart, Grundplatte.CATPart, ISO_2338_3x12_STEEL_PARALLEL_PIN_UNHARDENED.CATPart]
2022-10-30 Normteile Gehäuse eingefügt
    [603.000.00.000_Kugellabyrinth.CATProduct, ANSI_B27_7M_3CM1_4_STEEL_EXTERNAL_RETAINING_E_RING.CATPart, Abdeckplatte.CATPart, Auffangplatte.CATPart, Aufhaengung_1.CATPart, Aufhaengung_2.CATPart, Bananenstecker_rot.CATPart, Bananenstecker_schwarz.CATPart]
2022-10-31 Reparatur Verschraubung & Zeichnungsvorlagen
    Aufgrund eines Fehlers in CATIA wurden die Schrauben und Scheiben nicht mehr geladen. Habe die Dateien neu zugeordnet
    [ISO_4032_M6_STEEL_GRADE_A_HEXAGON_NUT.CATPart, ISO_7089_6x12_STEEL_GRADE_A_NORMAL_SERIES_PLAIN_WASHER.CATPart, Verschraubung.CATProduct]
2022-10-31 Zeichnungen Fernsteuerug
    [Abdeckplatte.CATPart, Distanzlage_6mm.CATPart, Fernsteuerung.CATProduct, Grundplatte.CATPart, ISO_2338_3x12_STEEL_PARALLEL_PIN_UNHARDENED.CATPart, Platine.CATProduct, Stückliste Fernsteuerung.xls, Verstiftung.CATPart]
2022-10-31 Kabelfrührung
    [603.000.00.000_Kugellabyrinth.CATProduct, Aufhaengung_1.CATPart, Gehaeuse.CATProduct, Gehaeuse_Bodenplatte.CATPart, Gehaeuse_Deckel.CATPart, Gehaeuse_Seitenplatte_3.CATPart, Gehaeuse_Seitenplatte_4.CATPart, Kabelstop.CATPart]
2022-10-31 Materialzuordnung für Massenermittlung
    Gesamtmasse bei ca. 1,5 kg
    [603.000.00.000_Kugellabyrinth.CATProduct, Abdeckplatte.CATPart, Auffangplatte.CATPart, Aufhaengung_1.CATPart, Aufhaengung_2.CATPart, Distanzstueck.CATPart, Distanzstueck_Lagerung.CATPart, Gehaeuse.CATProduct]
2022-10-31 Vorbereitung für Zeichnungen Gehäuse
    [Gehaeuse.CATProduct, Gehaeuse_Bodenplatte.CATPart, Gehaeuse_Deckel.CATPart, Gehaeuse_Seitenplatte_1.CATPart, Gehaeuse_Seitenplatte_2.CATPart, Gehaeuse_Seitenplatte_3.CATPart, Gehaeuse_Seitenplatte_4.CATPart, ISO_4762_M3x20_STEEL_HEXAGON_SOCKET_HEAD_CAP_SCREW.CATPart]
2022-10-31 Anfang meiner Zeichnungen (wird wohl eine lange nacht)
    [603.000.00.000_Kugellabyrinth.CATProduct, Labyrinth.CATProduct]
2022-10-31 Zeichnungssatz Gehäuse
    [Gehaeuse_Bodenplatte.CATPart, Gehaeuse_Deckel.CATPart, Gehaeuse_Seitenplatte_1.CATPart, Gehaeuse_Seitenplatte_2.CATPart, Gehaeuse_Seitenplatte_3.CATPart, Gehaeuse_Seitenplatte_4.CATPart]
2022-10-31 Platinen BOM, Schematic, Layout
    [SMD BOM 603.000.05.000, 603.000.04.005.xlsx]
2022-10-31 Zeichnungen Plexiglasteile Aufhängung
    [SMD BOM 603.000.05.000, 603.000.04.005.xlsx, Stückliste Fernsteuerung.xls]
2022-11-01 Zeichnungen Aufhängung
    [ISO_10642_M3x10_STEEL_HEXAGON_SOCKET_COUNTERSUNK_HEAD_SCREW.CATPart, ISO_4032_M3_STEEL_GRADE_A_HEXAGON_NUT.CATPart, ISO_4762_M3x20_STEEL_HEXAGON_SOCKET_HEAD_CAP_SCREW.CATPart, ISO_7089_3x7_STEEL_GRADE_A_NORMAL_SERIES_PLAIN_WASHER.CATPart, Rahmen.CATProduct, Stückliste Fernsteuerung.xls]
2022-11-01 Update Stückliste Fernsteuerung.xls
    [Stückliste Fernsteuerung.xls]
2022-11-01 Zeichnungen Rampe
    [Rampe 0-6.CATPart, Rampe 6-9.CATPart]
2022-11-04 Füße entfernt
    [603.000.00.000_Kugellabyrinth.CATProduct, Gehaeuse.CATProduct, Gehaeuse_Bodenplatte.CATPart, Labyrinth.CATProduct, Rahmen.CATProduct, Verschraubung.CATProduct]
2022-11-04 Kabelführung und Symmetrie Rahmenhalterung
    [603.000.00.000_Kugellabyrinth.CATProduct, Aufhaengung_1.CATPart, Gehaeuse.CATProduct, Gehaeuse_Deckel.CATPart, ISO_10642_M3x16_STEEL_HEXAGON_SOCKET_COUNTERSUNK_HEAD_SCREW.CATPart, Labyrinth.CATProduct, Rahmen.CATProduct, Rahmen_Stange_1_1.CATPart]
2022-11-04 Platinenschrauben hinzugefügt und Anpassungen
    [603.000.00.000_Kugellabyrinth.CATProduct, Gehaeuse.CATProduct, Gehaeuse_Seitenplatte_2.CATPart, ISO 4032 NUT M3 STEEL GRADE A HEXAGON.2.CATPart, ISO 7089 WASHER 3x7 STEEL GRADE A PLAIN NORMAL SERIES.2.CATPart, ISO_4762_M3x16_STEEL_HEXAGON_SOCKET_HEAD_CAP_SCREW.CATPart, Labyrinth.CATProduct, Platine.CATProduct]
2022-11-07 Pdf Upload
    [Stückliste Fernsteuerung.xls]
2022-11-07 Verbesserung Zeichnungen
    Fernsteuerung & Gehäuse verbessert. Vorlagen A4, A3 und A2 um die Angaben zur Oberflächengüte ergänzt.
    [Verstiftung.CATPart]
2022-11-07 Schickere Maße für Lagerblock
    [Lagereinsatz.CATPart]
2022-11-08 Zeichnungen Nacharbeit
    [Rahmen.CATProduct, Stückliste Fernsteuerung.xls]
2022-11-08 Zeichnungssatz vollständig
    [Abdeckplatte.CATPart, Labyrinthplatte.CATPart]
2022-11-12 Kopie für Fertigungszeichnungen
    [603.000.00.000_Kugellabyrinth.CATProduct, ANSI_B27_7M_3CM1_4_STEEL_EXTERNAL_RETAINING_E_RING.CATPart, Abdeckplatte.CATPart, Armkonstruktion.CATProduct, Auffangplatte.CATPart, Aufhaengung aussen.CATPart, Aufhaengung und Servos.CATProduct, Aufhaengung_1.CATPart]
2022-11-12 Zeichnungen für Laser
    Alles andere habe ich aus Speichergründen aus dem Verzeichnis "Fertigung" entfernt, Benötigtes kann ja später aus dem Original hierhin abgespeichert werden.
    [603.000.00.000_Kugellabyrinth.CATProduct, ANSI_B27_7M_3CM1_4_STEEL_EXTERNAL_RETAINING_E_RING.CATPart, Abdeckplatte.CATPart, Armkonstruktion.CATProduct, Auffangplatte.CATPart, Aufhaengung aussen.CATPart, Aufhaengung und Servos.CATProduct, Aufhaengung_1.CATPart]
2022-11-15 R0,2 ergänzt
    [603.000.00.000_Kugellabyrinth.CATProduct, Auffangplatte.CATPart, Gehaeuse.CATProduct, Labyrinth.CATProduct, Rahmen.CATProduct, Rampe 0-6.CATPart, Rampe 6-9.CATPart]
2022-11-15 Update 603.000.00.000 Laser 6mm.CATDrawing
2022-11-15 ergänzen des ordnersystems
2022-11-17 Farben der Zeichnungen korrigiert
2022-11-22 Lagereinsatz an Labyrinth angepasst
    [Distanzstueck_Lagerung.stl, Lagereinsatz.CATPart, Lagereinsatz.stl]
2022-11-29 Create 603.000.00.000 Laser 6mm Nachdruck 1.CATDrawing
    Laser-Zeichnungen für Ersatzteile
2022-11-29 Create Stückliste Labyrinth.xls
    [Stückliste Labyrinth.xls]
2022-11-30 update arduino
2022-12-02 Weiter in der Doku
2022-12-03 einbinden der Nutzwertanalysen
    [Nutzwertanalyse Aufhängung.xlsx, Nutzwertanalyse Fernbedienung.xlsx, Nutzwertanalyse Lagerung.xlsx]
2022-12-03 Einfügen und Einarbeiten der OneNote Notizen und
2022-12-04 Addition of the Final Arduino Programm
2022-12-05 dokumentation mpu und hs
2022-12-05 Nachdruck Laufschinenen
    [Laufschiene_Lager.CATPart]
2022-12-05 Einfügen der Bilder (Tests)
2022-12-13 Update Catia Zeichnungen
    [603.000.00.000_Kugellabyrinth.CATProduct, Gehaeuse.CATProduct, Labyrinth.CATProduct, Laufschiene_Lager.CATPart, Rahmen.CATProduct]
2022-12-20 Update Stückliste Labyrinth.xls
    [Stückliste Labyrinth.xls]
2022-12-20 Powerpoint schnell
    [Stückliste Labyrinth.xls]
